theworkisthework/terraPen-mechanical-design-files/README.md

# terraPen-mechanical-design-files
3D files &amp; BOM for A2 terraPen coreXY Plotter
