theworkisthework/terraPen-mechanical-design-files/terraPenA2 BOM.xlsx

Sheet: BOM
terraPen A2 – Bill of Materials (v2.4)
Public bill of materials for one terraPen A2. Prices are kept in a separate internal workbook.
Status: | OK – matches old master | CHANGED – qty differs from old master |  | NEW – missing from old master | CHECK – needs your decision
Ref | Part | Spec / size | Qty | Used in | Supplier | Primary link | eBay UK | Amazon UK | AliExpress
1 FRAME & STRUCTURE
1.01 | 2020 T-slot extrusion | 760 mm, cut, M5 tapped both ends | 4 | Frame – width | KJN Aluminium Profile (cut to size) | Open page (https://www.aluminium-profile.co.uk/black-ir-20x20-profile-ir37015blk/) | eBay (https://www.ebay.co.uk/sch/i.html?_nkw=2020+T+slot+aluminium+extrusion+760mm+cut+to+length) | Amazon (https://www.amazon.co.uk/s?k=2020+T+slot+aluminium+extrusion+760mm+cut+to+length) | AliExpress (https://www.aliexpress.com/wholesale?SearchText=2020+T+slot+aluminium+extrusion+760mm+cut+to+length)
1.02 | 2020 T-slot extrusion | 560 mm, cut, M5 tapped both ends | 4 | Frame – length | KJN Aluminium Profile (cut to size) | Open page (https://www.aluminium-profile.co.uk/black-ir-20x20-profile-ir37015blk/) | eBay (https://www.ebay.co.uk/sch/i.html?_nkw=2020+T+slot+aluminium+extrusion+560mm+cut+to+length) | Amazon (https://www.amazon.co.uk/s?k=2020+T+slot+aluminium+extrusion+560mm+cut+to+length) | AliExpress (https://www.aliexpress.com/wholesale?SearchText=2020+T+slot+aluminium+extrusion+560mm+cut+to+length)
1.03 | 2020 T-slot extrusion | 710 mm, cut (X rail) | 1 | Frame – X rail | KJN Aluminium Profile (cut to size) | Open page (https://www.aluminium-profile.co.uk/black-ir-20x20-profile-ir37015blk/) | eBay (https://www.ebay.co.uk/sch/i.html?_nkw=2020+T+slot+aluminium+extrusion+710mm+cut+to+length) | Amazon (https://www.amazon.co.uk/s?k=2020+T+slot+aluminium+extrusion+710mm+cut+to+length) | AliExpress (https://www.aliexpress.com/wholesale?SearchText=2020+T+slot+aluminium+extrusion+710mm+cut+to+length)
1.04 | 2020 T-slot extrusion | 50 mm, cut (uprights / legs), M5 tapped both ends | 4 | Frame – height | KJN Aluminium Profile (cut to size) | Open page (https://www.aluminium-profile.co.uk/black-ir-20x20-profile-ir37015blk/) | eBay (https://www.ebay.co.uk/sch/i.html?_nkw=2020+T+slot+aluminium+extrusion+45mm+cut) | Amazon (https://www.amazon.co.uk/s?k=2020+T+slot+aluminium+extrusion+45mm+cut) | AliExpress (https://www.aliexpress.com/wholesale?SearchText=2020+T+slot+aluminium+extrusion+45mm+cut)
1.05 | 2020 corner cube connector | 3-way, 20x20x20, black, 6 mm T-slot; sold as 12 with screws | 8 | Frame – corners | AliExpress (12 pcs) | Open page (https://www.aliexpress.com/item/1005013477214655.html) | eBay (https://www.ebay.co.uk/sch/i.html?_nkw=2020+3+way+corner+cube+connector+aluminium+profile) | Amazon (https://www.amazon.co.uk/s?k=2020+3+way+corner+cube+connector+aluminium+profile) | AliExpress (https://www.aliexpress.com/wholesale?SearchText=2020+3+way+corner+cube+connector+aluminium+profile)
1.06 | 2020 corner bracket | 90 degree, 20 x 20 x 17 mm aluminium; sold as 10 (5 machines) | 2 | Frame | AliExpress (10 pcs) | Open page (https://www.aliexpress.com/item/4000190579760.html) | eBay (https://www.ebay.co.uk/sch/i.html?_nkw=2020+aluminium+profile+90+degree+corner+bracket+L) | Amazon (https://www.amazon.co.uk/s?k=2020+aluminium+profile+90+degree+corner+bracket+L) | AliExpress (https://www.aliexpress.com/wholesale?SearchText=2020+aluminium+profile+90+degree+corner+bracket+L)
1.07 | Rubber feet | 20 mm dia x 15 mm high, conical black rubber with steel washer; sold in lots of 4 (one machine) | 4 | Frame – base | AliExpress (lot of 4) | Open page (https://www.aliexpress.com/item/33014925172.html) | eBay (https://www.ebay.co.uk/sch/i.html?_nkw=rubber+feet+20mm+diameter+15mm+high+M5) | Amazon (https://www.amazon.co.uk/s?k=rubber+feet+20mm+diameter+15mm+high+M5) | AliExpress (https://www.aliexpress.com/wholesale?SearchText=rubber+feet+20mm+diameter+15mm+high+M5)
1.09 | Metal baseboard with vinyl sticker | Ferrous Dibond-style composite, cut to shape; profile 'tP_Bed_Profile_Revised.dxf', artwork 'Diabond vinyl revised .ai' (both in /metal bed) | 1 | Base | Local sign shop | DXF file (https://github.com/theworkisthework/terraPen-mechanical-design-files/blob/main/metal%20bed/tP_Bed_Profile_Revised.dxf) | – | – | –
1.10 | IR Cover reduction profile (5), black (cosmetic slot cover) | KJN37080, 2 m lengths, fits the 5 mm slot; cut list about 5.8 m (6 x 560, 2 x 760, 1 x 710, 4 x 50 mm) | 3 | Frame – top and side trim, front legs | KJN Aluminium Profile | Open page (https://www.aluminium-profile.co.uk/cover-reduction-profile-kjn37080/)
1.11 | Corner cube hole caps, plastic | 11 mm plastic caps; sold as 100 pcs | 12 | Frame corners (cubes) | eBay UK (100 pcs) | Open page (https://www.ebay.co.uk/itm/206068130690?var=506833273757)
1.12 | Rubber bungs | 11 mm rubber bungs; sold as 50 pcs | 8 | Both sides of the plotter | eBay UK (50 pcs) | Open page (https://www.ebay.co.uk/itm/404287645922?var=674191197230)
1.13 | Neodymium magnets | Strong rare-earth magnets; sold as 50 | 4 | Metal bed (4 per machine); where exactly to confirm | eBay UK (50 pcs) | Open page (https://www.ebay.co.uk/itm/326521985418)
1.14 | Neodymium magnets, black, second listing | Sold as 4 | 4 | To confirm | eBay UK (4 pcs) | Open page (https://www.ebay.co.uk/itm/318885672822?var=617097751297)
2 LINEAR MOTION
2.01 | Linear rail + 1 block, MGN9H | 540 mm (Y axis) | 2 | Y left / Y right | Jugetek (custom cut) | Open page (https://www.jugetek.com/product-page/black-anodized-linear-rail-mgn7-mgn9-mgn12-mgn15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) | eBay (https://www.ebay.co.uk/sch/i.html?_nkw=MGN9H+linear+rail+540mm+with+carriage) | Amazon (https://www.amazon.co.uk/s?k=MGN9H+linear+rail+540mm+with+carriage) | AliExpress (https://www.aliexpress.com/wholesale?SearchText=MGN9H+linear+rail+540mm+with+carriage)
2.02 | Linear rail + 1 block, MGN9H | 710 mm (X axis) | 1 | X rail / carriage | Jugetek (custom cut) | Open page (https://www.jugetek.com/product-page/black-anodized-linear-rail-mgn7-mgn9-mgn12-mgn15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) | eBay (https://www.ebay.co.uk/sch/i.html?_nkw=MGN9H+linear+rail+710mm+with+carriage) | Amazon (https://www.amazon.co.uk/s?k=MGN9H+linear+rail+710mm+with+carriage) | AliExpress (https://www.aliexpress.com/wholesale?SearchText=MGN9H+linear+rail+710mm+with+carriage)
2.03 | Linear rail + 1 block, MGN7H | 50 mm (Z / pen lift) | 1 | Tool head | Jugetek (custom cut) | Open page (https://www.jugetek.com/product-page/black-anodized-linear-rail-mgn7-mgn9-mgn12-mgn15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) | eBay (https://www.ebay.co.uk/sch/i.html?_nkw=MGN7H+50mm+linear+rail+with+carriage+block) | Amazon (https://www.amazon.co.uk/s?k=MGN7H+50mm+linear+rail+with+carriage+block) | AliExpress (https://www.aliexpress.com/wholesale?SearchText=MGN7H+50mm+linear+rail+with+carriage+block)
3 DRIVE – BELTS, PULLEYS, MOTORS
3.01 | GT2 timing belt, open | 6 mm wide, open-ended, rubber/aramid; 4.2 m per machine (qty is in metres) | 4.2 | X and Y belts | AliExpress (5 m length) | Open page (https://www.aliexpress.com/item/10000401582873.html) | eBay (https://www.ebay.co.uk/sch/i.html?_nkw=GT2+timing+belt+6mm+open+3m) | Amazon (https://www.amazon.co.uk/s?k=GT2+timing+belt+6mm+open+3m) | AliExpress (https://www.aliexpress.com/wholesale?SearchText=GT2+timing+belt+6mm+open+3m)
3.02 | GT2 pulley, toothed drive | 20T, 5 mm bore, 6 mm belt; sold as 10 | 2 | X motor, Y motor | AliExpress (10 pcs) | Open page (https://www.aliexpress.com/item/1005010499786326.html) | eBay (https://www.ebay.co.uk/sch/i.html?_nkw=GT2+20+tooth+pulley+5mm+bore+6mm+belt) | Amazon (https://www.amazon.co.uk/s?k=GT2+20+tooth+pulley+5mm+bore+6mm+belt) | AliExpress (https://www.aliexpress.com/wholesale?SearchText=GT2+20+tooth+pulley+5mm+bore+6mm+belt)
3.03 | GT2 idler, smooth | 20T smooth (no teeth), 5 mm bore, 6 mm belt, with bearing; sold as 4 | 4 | X/Y idlers, Y left/right, motor mounts | AliExpress (4 pcs) | Open page (https://www.aliexpress.com/item/32726309946.html) | eBay (https://www.ebay.co.uk/sch/i.html?_nkw=GT2+20T+smooth+idler+pulley+5mm+bore+6mm+belt) | Amazon (https://www.amazon.co.uk/s?k=GT2+20T+smooth+idler+pulley+5mm+bore+6mm+belt) | AliExpress (https://www.aliexpress.com/wholesale?SearchText=GT2+20T+smooth+idler+pulley+5mm+bore+6mm+belt)
3.04 | GT2 idler, toothed | 20T, 5 mm bore, 6 mm belt, with bearing; sold as 10 | 8 | X/Y idlers, Y left/right, motor mounts | AliExpress (10 pcs) | Open page (https://www.aliexpress.com/item/32726309946.html) | eBay (https://www.ebay.co.uk/sch/i.html?_nkw=GT2+20T+toothed+idler+pulley+5mm+bore+6mm+belt+with+bearing) | Amazon (https://www.amazon.co.uk/s?k=GT2+20T+toothed+idler+pulley+5mm+bore+6mm+belt+with+bearing) | AliExpress (https://www.aliexpress.com/wholesale)
3.05 | NEMA 17 stepper motor, 17HS15-1504S-X1 | 42x42x39 mm (page also says 40), 1.8 deg, 1.5 A, 45 N.cm, 2.3 ohm, 4.4 mH; 5 mm D-cut shaft; 1 m lead with pin connector | 2 | X motor, Y motor | StepperOnline UK | Open page (https://www.stepperonline.co.uk/nema-17-bipolar-45ncm-63-74oz-in-1-5a-42x42x39mm-4-wires-w-1m-pin-connector-17hs15-1504s-x1.html) | eBay (https://www.ebay.co.uk/sch/i.html?_nkw=NEMA+17+stepper+1.7A+42x42x38+bipolar) | Amazon (https://www.amazon.co.uk/s?k=NEMA+17+stepper+1.7A+42x42x38+bipolar) | AliExpress (https://www.aliexpress.com/wholesale?SearchText=NEMA+17+stepper+1.7A+42x42x38+bipolar)
4 ELECTRONICS
4.01 | Emerald Dingo ESP32 plotter controller (RevB) | FluidNC, 2-axis, TMC2130 driver sockets, USB-C | 1 | Electronics enclosure | terrapen.xyz | Open page (https://terrapen.xyz/products/emerald-dingo-esp32-plotter-controller?variant=64807034749305) | – | – | –
4.02 | TMC2130 stepper driver | 3: X, Y and Z (Z via the Z-axis add-on) | 3 | Controller | AliExpress | Open page (https://www.aliexpress.com/item/1005004590796152.html) | – | – | –
4.03 | Emerald Dingo Z-axis add-on | Z motor add-on; the Z lead plugs into this | 1 | Controller | terrapen.xyz | Open page (https://terrapen.xyz/products/emerald-dingo-esp32-plotter-controller?variant=64807034749305) | – | – | –
4.04 | Micro SD card, 2 GB | Cloudisk 2 GB microSD with adapter; sold as 5 | 1 | Controller | Amazon UK (5 pack) | Open page (https://www.amazon.co.uk/dp/B07R2J5CC4) | eBay (https://www.ebay.co.uk/sch/i.html?_nkw=microSD+card+8GB+SanDisk) | Amazon (https://www.amazon.co.uk/s?k=microSD+card+8GB+SanDisk) | AliExpress (https://www.aliexpress.com/wholesale?SearchText=microSD+card+8GB+SanDisk)
4.05 | Power supply, 12 V dc, 2.5 A (Ideal Power 15DYS830-120250W-K) | 12 V 2.5 A, 2.1 x 5.5 mm centre-positive barrel plug, 1.5 m lead, interchangeable AU/EU/UK/US mains plugs | 1 | Power | Farnell UK | Open page (https://uk.farnell.com/ideal-power/15dys830-120250w-k/adapter-ac-dc-12v-2-5a/dp/3703709) | eBay (https://www.ebay.co.uk/sch/i.html?_nkw=12V+2A+power+supply+5.5x2.1mm+UK+plug) | Amazon (https://www.amazon.co.uk/s?k=12V+2A+power+supply+5.5x2.1mm+UK+plug) | AliExpress (https://www.aliexpress.com/wholesale?SearchText=12V+2A+power+supply+5.5x2.1mm+UK+plug)
4.06 | Motor cable, 4-way | 4-core PVC cable, 26 AWG, flexible, unshielded, 920 mm, JST PH 2.0 | 1 | X motor |  | – | eBay (https://www.ebay.co.uk/sch/i.html?_nkw=JST+PH+2.0+4+pin+cable+750mm) | Amazon (https://www.amazon.co.uk/s?k=JST+PH+2.0+4+pin+cable+750mm) | AliExpress (https://www.aliexpress.com/wholesale?SearchText=JST+PH+2.0+4+pin+cable+750mm)
4.07 | Motor cable, 4-way | 4-core PVC cable, 26 AWG, flexible, unshielded, 515 mm, JST PH 2.0 | 1 | Y motor |  | – | eBay (https://www.ebay.co.uk/sch/i.html?_nkw=JST+PH+2.0+4+pin+cable+500mm) | Amazon (https://www.amazon.co.uk/s?k=JST+PH+2.0+4+pin+cable+500mm) | AliExpress (https://www.aliexpress.com/wholesale?SearchText=JST+PH+2.0+4+pin+cable+500mm)
4.08 | Hook-up wire, Alpha Wire 3049 BK001 | 26 AWG PVC black, 7 x 34 tinned stranded, 300 V (order code 01-5540). Sold on a 1000 ft (304.8 m) reel; only part of it is used per machine | 15 | Z motor lead (4 x 2100 mm) and X endstop lead (3 x 2100 mm) = 14.7 m, 15 m with trimming | Rapid Electronics | Open page (https://www.rapidonline.com/alpha-wire-3049-bk001-26-awg-pvc-black-hook-up-wire-1kft-01-5540) | – | – | –
4.09 | Multicore cable, 4-core PVC | 26 AWG, flexible PVC, unshielded: X lead 920 mm + Y lead 515 mm (1.435 m), plus spare | 1.5 | X and Y motors | eBay UK (20 m reel) | Open page (https://www.ebay.co.uk/itm/398302213229?var=666566085777) | eBay (https://www.ebay.co.uk/sch/i.html?_nkw=4+core+26+AWG+PVC+cable+per+metre) | Amazon (https://www.amazon.co.uk/s?k=4+core+26+AWG+PVC+cable+per+metre) | AliExpress (https://www.aliexpress.com/wholesale?SearchText=4+core+26+AWG+PVC+cable+per+metre)
4.10 | Multicore cable, 3-core PVC | 3-core PVC, 26 AWG (confirm); Y endstop lead only, 920 mm, plus spare | 1 | Y endstop | eBay UK (20 m reel) | Open page (https://www.ebay.co.uk/itm/398302213229?var=666566085742) | eBay (https://www.ebay.co.uk/sch/i.html?_nkw=3+core+26+AWG+PVC+cable+per+metre) | Amazon (https://www.amazon.co.uk/s?k=3+core+26+AWG+PVC+cable+per+metre) | AliExpress (https://www.aliexpress.com/wholesale?SearchText=3+core+26+AWG+PVC+cable+per+metre)
4.11 | JST PH 2.0 connector kit | 420 pcs: PH housings (2 to 6-way, male and female) and 270 crimp terminals; sold as one kit | 1 | All JST PH plugs: controller ends (3 x 4-way motor/Z, 2 x 3-way endstop) and motor ends (2 x 6-way) | eBay UK (kit) | Open page (https://www.ebay.co.uk/itm/307018351125) | eBay (https://www.ebay.co.uk/sch/i.html?_nkw=JST+PH+2.0+connector+housing+crimp+kit) | Amazon (https://www.amazon.co.uk/s?k=JST+PH+2.0+connector+housing+crimp+kit) | AliExpress (https://www.aliexpress.com/wholesale?SearchText=JST+PH+2.0+connector+housing+crimp+kit)
4.12 | Insulation tape for colour-coding | Red, green, yellow and blue, cut into 1 mm strips wrapped near each crimp | 4 | Z lead and other single-core wires | Local shop (similar on eBay) | – | eBay (https://www.ebay.co.uk/sch/i.html?_nkw=insulation+tape+assorted+colours+electrical+PVC) | Amazon (https://www.amazon.co.uk/s?k=insulation+tape+assorted+colours+electrical+PVC) | AliExpress (https://www.aliexpress.com/wholesale?SearchText=insulation+tape+assorted+colours+electrical+PVC)
4.13 | JST SM 2.54 mm connector kit | 200 pcs: SM-02 to SM-05 male and female housings (5 of each) + 80 bare female and 80 bare male terminals | 1 | Z motor lead (1 x 4F, 1 x 4M); X and Y endstop leads (2 x 3F) | eBay UK (kit) | Open page (https://www.ebay.co.uk/itm/820271314350) | eBay (https://www.ebay.co.uk/sch/i.html?_nkw=JST+SM+connector+kit+male+female+crimp+2.5mm) | Amazon (https://www.amazon.co.uk/s?k=JST+SM+connector+kit+male+female+crimp+2.5mm) | AliExpress (https://www.aliexpress.com/wholesale?SearchText=JST+SM+connector+kit+male+female+crimp+2.5mm)
4.14 | Optical endstop | 3-pin module (SIG / GND / VCC) | 2 | X and Y limits | Ooznest (SKU ESTOP-O) | Open page (https://ooznest.co.uk/product/optical-endstop/) | eBay (https://www.ebay.co.uk/sch/i.html?_nkw=optical+endstop+switch+module+3D+printer) | Amazon (https://www.amazon.co.uk/s?k=optical+endstop+switch+module+3D+printer) | AliExpress (https://www.aliexpress.com/wholesale?SearchText=optical+endstop+switch+module+3D+printer)
4.15 | Standoff, male-female, polyamide (WA-SPAIE) | M3 x 18 mm, hex 6 mm, black; Wurth Elektronik 971180365 | 2 | Electronics enclosure | Mouser UK | Open page (https://www.mouser.co.uk/en/ProductDetail/Wurth-Elektronik/971180365?qs=%252BEew9%252B0nqrDVrObtSz99Gg%3D%3D) | eBay (https://www.ebay.co.uk/sch/i.html?_nkw=nylon+M3+standoff+20mm) | Amazon (https://www.amazon.co.uk/s?k=nylon+M3+standoff+20mm) | AliExpress (https://www.aliexpress.com/wholesale?SearchText=nylon+M3+standoff+20mm)
4.16 | Standoff, male-female, nylon (Essentra 36M30MF016) | M3 x 16 mm hex standoff, 6 mm hex, natural nylon 6/6 (Z add-on only) | 1 | Electronics enclosure, only if you fit the Z-axis add-on | Mouser UK | Open page (https://www.mouser.co.uk/en/ProductDetail/Essentra/36M30MF016?qs=PzGy0jfpSMv9qGPovnFAAw%3D%3D)
4.17 | DC barrel jack: plug and socket pair | Plug + female socket (size to confirm); sold as 10 pairs | 1 | Power connection | eBay UK (10 pairs) | Open page (https://www.ebay.co.uk/itm/224610270674)
4.18 | Mains/power lead wire, 2-core 18 AWG | 18 AWG 2-core, 16 A rated; about 750 mm per machine, sold in 10 m lengths | 0.75 | Power wiring | eBay UK (10 m) | Open page (https://www.ebay.co.uk/itm/377319331207?var=645666841133)
4.19 | Power switch, rocker | Rocker switch; sold as 5 pcs | 1 | Power switch mount | eBay UK (5 pcs) | Open page (https://www.ebay.co.uk/itm/398214541037)
4.21 | Waveshare round display (terraDial) | Optional dial controller module for the terraDial add-on | 0 | Optional: terraDial | AliExpress | Open page (https://www.aliexpress.com/item/1005010074372646.html)
5 CABLE MANAGEMENT & MISC
5.01 | Cable chain | 7 x 7 mm inner, black nylon, sold in 1 m lengths with 2 end connectors; about 1.4 m needed (qty in metres) | 1.4 | Y right and carriage | AliExpress (1 m lengths) | Open page (https://www.aliexpress.com/item/10000358224332.html) | eBay (https://www.ebay.co.uk/sch/i.html?_nkw=7x7+cable+drag+chain+1m) | Amazon (https://www.amazon.co.uk/s?k=7x7+cable+drag+chain+1m) | AliExpress (https://www.aliexpress.com/wholesale?SearchText=7x7+cable+drag+chain+1m)
5.02 | D-Line Micro+ trunking, black | 20 x 10 mm, 2 m length, self-adhesive (Screwfix 960RA); about 1.6 m needed | 1 | Underside cable routing | Screwfix | Open page (https://www.screwfix.com/p/d-line-pvc-black-micro-trunking-20mm-x-10mm-x-2m/960ra)
5.03 | Trunking 90-degree flat corner | Print your own (D_Line_20x10_Flat_corner.stl, see 10.50), or the D-Line accessories pack (5 pieces, black) | 2 | Underside cable routing | Screwfix, or print in-house | Open page (https://www.screwfix.com/p/d-line-abs-plastic-black-trunking-accessories-5-pieces/117fg)
5.04 | Cable ties | Black nylon, 2.5 mm wide; sold as 100 | 6 | General | eBay UK (100 pcs) | Open page (https://www.ebay.co.uk/itm/366488071588?var=636217771991) | eBay (https://www.ebay.co.uk/sch/i.html?_nkw=cable+ties+100mm+x+2.5mm) | Amazon (https://www.amazon.co.uk/s?k=cable+ties+100mm+x+2.5mm) | AliExpress (https://www.aliexpress.com/wholesale?SearchText=cable+ties+100mm+x+2.5mm)
5.05 | Hex key set | 1.5 / 2 / 2.5 / 3 / 4 mm | 1 | Assembly (tool) |  | – | eBay (https://www.ebay.co.uk/sch/i.html?_nkw=hex+key+set+1.5+2+2.5+3+4mm) | Amazon (https://www.amazon.co.uk/s?k=hex+key+set+1.5+2+2.5+3+4mm) | AliExpress (https://www.aliexpress.com/wholesale?SearchText=hex+key+set+1.5+2+2.5+3+4mm)
6 FASTENERS – M2
6.02 | Socket head screw | M2 x 8, self colour, hex socket | 7 | Stepper tool head: MGN7H rail on the plate | Allfix | Open page (https://allfix.co.uk/m2-x-8-socket-head-capscrew-steel-self-colour-scp0scm020x0008.html)
6.04 | Heat-set insert | M2 x 3 mm brass | 3 | Tool head | eBay UK (100 pack) | Open page (https://www.ebay.co.uk/itm/316492832478) | eBay (https://www.ebay.co.uk/sch/i.html?_nkw=M2+heat+set+threaded+insert+brass) | Amazon (https://www.amazon.co.uk/s?k=M2+heat+set+threaded+insert+brass) | AliExpress (https://www.aliexpress.com/wholesale?SearchText=M2+heat+set+threaded+insert+brass)
7 FASTENERS – M3
7.01 | Countersunk screw | M3 x 5, self colour, hex socket | 6 | Y right, carriage, tool head | Allfix | Open page (https://allfix.co.uk/m3-x-5-socket-countersunk-steel-self-colour-sck0scm030x0005.html) | – | – | –
7.02 | Countersunk screw | M3 x 6, self colour, hex socket | 17 | Y left/right, carriage, tool head, electronics | Allfix | Open page (https://allfix.co.uk/m3-x-6-socket-countersunk-steel-self-colour-sck0scm030x0006.html) | – | – | –
7.03 | Countersunk screw | M3 x 8, self colour, hex socket | 15 | Y right | Allfix | Open page (https://allfix.co.uk/m3-x-8-socket-countersunk-steel-self-colour-sck0scm030x0008.html) | – | – | –
7.05 | Countersunk screw | M3 x 16, self colour, hex socket | 5 | To confirm | Allfix | Open page (https://allfix.co.uk/m3-x-16-socket-countersunk-steel-self-colour-sck0scm030x0016.html)
7.07 | Countersunk screw | M3 x 30, self colour, hex socket | 4 | X/Y motor mount | Allfix | Open page (https://allfix.co.uk/m3-x-30-socket-countersunk-steel-self-colour-sck0scm030x0030.html) | – | – | –
7.08 | Button head screw | M3 x 6, self colour, hex socket | 6 | Tool head, electronics | Allfix | Open page (https://allfix.co.uk/m3-x-6-socket-button-head-steel-self-colour-sbn0scm030x0006.html) | – | – | –
7.09 | Button head screw | M3 x 8, self colour, hex socket | 1 | Controller board, only with the Z-axis add-on | Allfix | Open page (https://allfix.co.uk/m3-x-8-socket-button-head-steel-self-colour-sbn0scm030x0008.html)
7.10 | Button head screw | M3 x 16 (approx.), self colour, hex socket; feet are bought without a bolt | 4 | Frame – feet | Allfix | Open page (https://allfix.co.uk/m3-x-16-socket-button-head-steel-self-colour-sbn0scm030x0016.html) | – | – | –
7.12 | Socket head screw | M3 x 8, self colour, hex socket | 14 | Frame – rails | Allfix | Open page (https://allfix.co.uk/m3-x-8-socket-head-capscrew-steel-self-colour-scp0scm030x0008.html) | – | – | –
7.13 | Nyloc nut | M3, A2-304 stainless steel, DIN 985 type T | 2 | Z tool head (new) | Allfix | Open page (https://allfix.co.uk/m3-nyloc-nut-type-t-a2-304-stainless-steel-din-985-nunt2scm030.html)
7.14 | T-slot nut with spring ball, M3 (IR Slot 5 slide block) | KJN43719, M3, 5 mm slot, 8 x 4.2 mm, zinc-plated steel, stainless spring ball | 17 | Frame – rails and feet | KJN Aluminium Profile | Open page (https://www.aluminium-profile.co.uk/t-slot-nut-5-st-m3-with-spring-ball-kjn43719/) | eBay (https://www.ebay.co.uk/sch/i.html?_nkw=M3+drop+in+T+nut+2020+profile) | Amazon (https://www.amazon.co.uk/s?k=M3+drop+in+T+nut+2020+profile) | AliExpress (https://www.aliexpress.com/wholesale?SearchText=M3+drop+in+T+nut+2020+profile)
7.15 | Heat-set insert | M3 x 3 mm brass | 1 | Belt clamp, rear of the tool head | The Pi Hut | Open page (https://thepihut.com/products/brass-heat-set-inserts-for-plastic-m3-x-3mm-50-pack) | eBay (https://www.ebay.co.uk/sch/i.html?_nkw=M3+heat+set+insert+M3x3+brass) | Amazon (https://www.amazon.co.uk/s?k=M3+heat+set+insert+M3x3+brass) | AliExpress (https://www.aliexpress.com/wholesale?SearchText=M3+heat+set+insert+M3x3+brass)
8 FASTENERS – M5
8.01 | Countersunk screw | M5 x 8, self colour, hex socket | 33 | Motors, idlers, Y left/right (18); metal bed (8) | Allfix | Open page (https://allfix.co.uk/m5-x-8-socket-countersunk-steel-self-colour-sck0scm050x0008.html) | – | – | –
8.02 | Countersunk screw | M5 x 20, self colour, hex socket | 6 | Y left/right – X rail mounting | Allfix | Open page (https://allfix.co.uk/m5-x-20-socket-countersunk-steel-self-colour-sck0scm050x0020.html) | – | – | –
8.04 | Button head screw | M5 x 12, self colour, hex socket | 22 | Frame – corner cubes (all 22) | Allfix | Open page (https://allfix.co.uk/m5-x-12-socket-button-head-steel-self-colour-sbn0scm050x0012.html)
8.05 | Button head screw | M5 x 8, self colour, hex socket | 6 | Frame 90-degree corners (4), electronics enclosure (2) | Allfix | Open page (https://allfix.co.uk/m5-x-8-socket-button-head-steel-self-colour-sbn0scm050x0008.html) | – | – | –
8.07 | T-slot nut with spring ball, M5 (IR Slot 5 slide block) | KJN37001, M5, 5 mm slot, 8 x 4.2 mm, zinc-plated steel, stainless spring ball | 43 | Motors, idlers, Y left/right, frame rails | KJN Aluminium Profile | Open page (https://www.aluminium-profile.co.uk/t-slot-nut-5-st-m3-with-spring-ball-pk-10-kjn37001/) | eBay (https://www.ebay.co.uk/sch/i.html?_nkw=M5+drop+in+T+nut+2020+profile) | Amazon (https://www.amazon.co.uk/s?k=M5+drop+in+T+nut+2020+profile) | AliExpress (https://www.aliexpress.com/wholesale?SearchText=M5+drop+in+T+nut+2020+profile)
8.08 | Allfix fixings – total for one machine | All the Allfix screws and nuts above, at exact per-machine quantities | 1 | Whole machine | Allfix | –
9 Z-STEPPER PEN-LIFT HEAD
9.01 | NEMA 14 stepper motor, 14HS17-0504S | 35 x 35 x 42 mm, 1.8 deg, 0.5 A, 23 N·cm; 5 mm D-cut shaft (24 mm); 300 mm lead, 4 wires | 1 | Pen lift | StepperOnline UK | Open page (https://www.stepperonline.co.uk/nema-14-bipolar-1-8deg-23ncm-32-57oz-in-0-5a-35x35x42mm-4-wires-14hs17-0504s.html) | eBay (https://www.ebay.co.uk/sch/i.html?_nkw=NEMA+14+stepper+motor+35mm+bipolar+1.8+degree) | Amazon (https://www.amazon.co.uk/s?k=NEMA+14+stepper+motor+35mm+bipolar+1.8+degree) | AliExpress (https://www.aliexpress.com/wholesale?SearchText=NEMA+14+stepper+motor+35mm+bipolar+1.8+degree)
9.02 | GT2 timing belt, 6 mm (pen lift) | 6 mm wide, about 40 mm, cut from the same reel as the X/Y belts (row 3.01); qty in metres | 0.04 | Pen lift | AliExpress (same reel as 3.01) | Open page (https://www.aliexpress.com/item/10000401582873.html) | eBay (https://www.ebay.co.uk/sch/i.html?_nkw=GT2+timing+belt+6mm+open+per+metre) | Amazon (https://www.amazon.co.uk/s?k=GT2+timing+belt+6mm+open+per+metre) | AliExpress (https://www.aliexpress.com/wholesale?SearchText=GT2+timing+belt+6mm+open+per+metre)
9.03 | Z motor lead (through the energy chain) | 4 x single-core Alpha Wire 3049 BK001, 26 AWG tinned copper PVC, black; 2100 mm each | 1 | Z motor | Made from the hook-up wire above | – | – | – | –
9.04 | Extension spring | 5.2 mm diameter x 20.6 mm long, 0.3 mm wire; sold as 10 | 1 | Stepper tool head (front of the plate, bottom left corner) | eBay UK (10 pcs) | Open page (https://www.ebay.co.uk/itm/406338225404?var=676666549225)
9.06 | Thumb screw, M3 x 12 | Steel thumb screw (knurled head); sold as 10 | 1 | Pen setter gauge | AliExpress (10 pcs) | Open page (https://www.aliexpress.com/item/1005009244888323.html)
10 PRINTED PARTS (STL – print in-house)
10.01 | X idler top (XIT) | X_Idler_Top.stl | 1 | X idler | Print in-house | Link (https://github.com/theworkisthework/terraPen-mechanical-design-files/blob/main/STLs/X_Idler_Top.stl) | – | – | –
10.02 | X idler bottom (XIB) | X_Idler_Bottom.stl | 1 | X idler | Print in-house | Link (https://github.com/theworkisthework/terraPen-mechanical-design-files/blob/main/STLs/X_Idler_Bottom.stl) | – | – | –
10.03 | Y idler top (YIT) | Y_Idler_Top.stl | 1 | Y idler | Print in-house | Link (https://github.com/theworkisthework/terraPen-mechanical-design-files/blob/main/STLs/Y_Idler_Top.stl) | – | – | –
10.04 | Y idler bottom (YIB) | Y_Idler_Bottom.stl | 1 | Y idler | Print in-house | Link (https://github.com/theworkisthework/terraPen-mechanical-design-files/blob/main/STLs/Y_Idler_Bottom.stl) | – | – | –
10.05 | X motor top (XMT) | X_Motor_Top.stl | 1 | X motor | Print in-house | Link (https://github.com/theworkisthework/terraPen-mechanical-design-files/blob/main/STLs/X_Motor_Top.stl) | – | – | –
10.06 | X motor bottom (XMB) | X_Motor_Bottom.stl | 1 | X motor | Print in-house | Link (https://github.com/theworkisthework/terraPen-mechanical-design-files/blob/main/STLs/X_Motor_Bottom.stl) | – | – | –
10.07 | Y motor top (YMT) | Y_Motor_Top.stl | 1 | Y motor | Print in-house | Link (https://github.com/theworkisthework/terraPen-mechanical-design-files/blob/main/STLs/Y_Motor_Top.stl) | – | – | –
10.08 | Y motor bottom (YMB) | Y_Motor_Bottom.stl | 1 | Y motor | Print in-house | Link (https://github.com/theworkisthework/terraPen-mechanical-design-files/blob/main/STLs/Y_Motor_Bottom.stl) | – | – | –
10.09 | X axis bracket top, left (XYT) | Xy_Carriage_Top.stl | 1 | Y left | Print in-house | Link (https://github.com/theworkisthework/terraPen-mechanical-design-files/blob/main/STLs/Xy_Carriage_Top.stl) | – | – | –
10.10 | X axis bracket bottom, left (XYB) | Xy_Carriage_Bottom.stl | 1 | Y left | Print in-house | Link (https://github.com/theworkisthework/terraPen-mechanical-design-files/blob/main/STLs/Xy_Carriage_Bottom.stl) | – | – | –
10.11 | X axis bracket top, right (YXT) | Xx_Carriage_Top.stl | 1 | Y right | Print in-house | Link (https://github.com/theworkisthework/terraPen-mechanical-design-files/blob/main/STLs/Xx_Carriage_Top.stl) | – | – | –
10.12 | X axis bracket bottom, right (YXB) | Xx_Carraiage_Bottom.stl | 1 | Y right | Print in-house | Link (https://github.com/theworkisthework/terraPen-mechanical-design-files/blob/main/STLs/Xx_Carraiage_Bottom.stl) | – | – | –
10.14 | Carriage (RUM) | Tool_Carriage.stl | 1 | Carriage | Print in-house | Link (https://github.com/theworkisthework/terraPen-mechanical-design-files/blob/main/STLs/Tool_Carriage.stl) | – | – | –
10.15 | Belt clamp front (BCF) | Belt_Clamp_Plate.stl | 1 | Carriage | Print in-house | Link (https://github.com/theworkisthework/terraPen-mechanical-design-files/blob/main/STLs/Belt_Clamp_Plate.stl) | – | – | –
10.16 | Belt clamp back (BCB) | Belt_Clamp_Teeth.stl | 1 | Carriage | Print in-house | Link (https://github.com/theworkisthework/terraPen-mechanical-design-files/blob/main/STLs/Belt_Clamp_Teeth.stl) | – | – | –
10.17 | Tensioner housing (T) | Tensioner_Housing.stl | 1 | Carriage | Print in-house | Link (https://github.com/theworkisthework/terraPen-mechanical-design-files/blob/main/STLs/Tensioner_Housing.stl) | – | – | –
10.18 | Tensioner bit | 2xTensioner_bit.stl | 2 | Carriage | Print in-house | Link (https://github.com/theworkisthework/terraPen-mechanical-design-files/blob/main/STLs/2xTensioner_bit.stl) | – | – | –
10.20 | Minimal pen holder (MPH) | Pen_Holder_Front.stl | 1 | Tool head | Print in-house | Link (https://github.com/theworkisthework/terraPen-mechanical-design-files/blob/main/STLs/Pen_Holder_Front.stl) | – | – | –
10.21 | Pen clip block | Pen_Clip_Block.stl | 1 | Tool head | Print in-house | Link (https://github.com/theworkisthework/terraPen-mechanical-design-files/blob/main/STLs/Pen_Clip_Block.stl) | – | – | –
10.22 | Pen clip latch | Pen_Clip_Latch.stl | 1 | Tool head | Print in-house | Link (https://github.com/theworkisthework/terraPen-mechanical-design-files/blob/main/STLs/Pen_Clip_Latch.stl) | – | – | –
10.23 | Pen clip link | Pen_Clip_Link.stl | 1 | Tool head | Print in-house | Link (https://github.com/theworkisthework/terraPen-mechanical-design-files/blob/main/STLs/Pen_Clip_Link.stl) | – | – | –
10.24 | Electronics enclosure (EE) | Electronics Enclosure.stl | 1 | Electronics | Print in-house | Link (https://github.com/theworkisthework/terraPen-mechanical-design-files/blob/main/STLs/Electronics%20Enclosure.stl) | – | – | –
10.25 | Electronics enclosure top plate (EETP) | No STL found | 1 | Electronics | Print in-house | – | – | – | –
10.26 | Power enclosure box | Power_Enclosure_Box.stl | 1 | Power | Print in-house | Link (https://github.com/theworkisthework/terraPen-mechanical-design-files/blob/main/STLs/Power_Enclosure_Box.stl) | – | – | –
10.27 | Power enclosure back | Power_Enclosure_Back.stl | 1 | Power | Print in-house | Link (https://github.com/theworkisthework/terraPen-mechanical-design-files/blob/main/STLs/Power_Enclosure_Back.stl) | – | – | –
10.28 | X endstop top | Xx_Endstop_Top .stl | 1 | X endstop | Print in-house | Link (https://github.com/theworkisthework/terraPen-mechanical-design-files/blob/main/STLs/Xx_Endstop_Top%20.stl) | – | – | –
10.29 | X endstop bottom | Xx_Endstop_Bottom.stl | 1 | X endstop | Print in-house | Link (https://github.com/theworkisthework/terraPen-mechanical-design-files/blob/main/STLs/Xx_Endstop_Bottom.stl) | – | – | –
10.30 | Y endstop mount | Y_Endstop_Mount.stl | 1 | Y endstop | Print in-house | Link (https://github.com/theworkisthework/terraPen-mechanical-design-files/blob/main/STLs/Y_Endstop_Mount.stl) | – | – | –
10.31 | TPU bumper | 8xTPU_Bumper.stl | 8 | Frame / base | Print in-house | Link (https://github.com/theworkisthework/terraPen-mechanical-design-files/blob/main/STLs/8xTPU_Bumper.stl) | – | – | –
10.32 | Cable cap for extrusion | Cable Cap for Extrusion.stl | 1 | Frame | Print in-house | Link (https://github.com/theworkisthework/terraPen-mechanical-design-files/blob/main/STLs/Cable%20Cap%20for%20Extrusion.stl) | – | – | –
10.33 | Clip mount | skinnyClipMount.stl | 1 | Unknown | Print in-house | Link (https://github.com/theworkisthework/terraPen-mechanical-design-files/blob/main/STLs/skinnyClipMount.stl) | – | – | –
10.34 | Stepper tool carriage | stepper_tool_carriage.stl | 1 | Tool head (stepper) | Print in-house | Link (https://github.com/theworkisthework/terraPen-mechanical-design-files/blob/main/STLs/stepper_tool_carriage.stl) | – | – | –
10.35 | Stepper pen mount | stepper_pen_mount.stl | 1 | Tool head (stepper) | Print in-house | Link (https://github.com/theworkisthework/terraPen-mechanical-design-files/blob/main/STLs/stepper_pen_mount.stl) | – | – | –
10.36 | Stepper pen mount clamp | stepper_pen_mount_clamp.stl | 1 | Tool head (stepper) | Print in-house | Link (https://github.com/theworkisthework/terraPen-mechanical-design-files/blob/main/STLs/stepper_pen_mount_clamp.stl) | – | – | –
10.37 | Stepper belt pulley | stepper belt pulley.stl | 1 | Tool head (stepper) | Print in-house | Link (https://github.com/theworkisthework/terraPen-mechanical-design-files/blob/main/STLs/stepper%20belt%20pulley.stl) | – | – | –
10.38 | NEMA 14 mount to carriage | Nema14mount2carriage.stl | 1 | Tool head (stepper) | Print in-house | Link (https://github.com/theworkisthework/terraPen-mechanical-design-files/blob/main/STLs/Nema14mount2carriage.stl) | – | – | –
10.39 | TPU pen bung – 10mm Tapered | TPU Bungs/10mm Tapered Bung.stl | 1 | Pen holder insert | Print in-house | Link (https://github.com/theworkisthework/terraPen-mechanical-design-files/blob/main/STLs/TPU%20Bungs/10mm%20Tapered%20Bung.stl) | – | – | –
10.40 | TPU pen bung – 11mm Tapered | TPU Bungs/11mm Tapered Bung.stl | 1 | Pen holder insert | Print in-house | Link (https://github.com/theworkisthework/terraPen-mechanical-design-files/blob/main/STLs/TPU%20Bungs/11mm%20Tapered%20Bung.stl) | – | – | –
10.41 | TPU pen bung – 12mm Aperture | TPU Bungs/12mm Aperture Bung.stl | 1 | Pen holder insert | Print in-house | Link (https://github.com/theworkisthework/terraPen-mechanical-design-files/blob/main/STLs/TPU%20Bungs/12mm%20Aperture%20Bung.stl) | – | – | –
10.42 | TPU pen bung – 15mm Aperture | TPU Bungs/15mm Aperture Bung.stl | 1 | Pen holder insert | Print in-house | Link (https://github.com/theworkisthework/terraPen-mechanical-design-files/blob/main/STLs/TPU%20Bungs/15mm%20Aperture%20Bung.stl) | – | – | –
10.43 | TPU pen bung – 16_3mm Tapered | TPU Bungs/16_3mm Tapered Bung.stl | 1 | Pen holder insert | Print in-house | Link (https://github.com/theworkisthework/terraPen-mechanical-design-files/blob/main/STLs/TPU%20Bungs/16_3mm%20Tapered%20Bung.stl) | – | – | –
10.44 | TPU pen bung – 4mm Aperture | TPU Bungs/4mm Aperture Bung.stl | 1 | Pen holder insert | Print in-house | Link (https://github.com/theworkisthework/terraPen-mechanical-design-files/blob/main/STLs/TPU%20Bungs/4mm%20Aperture%20Bung.stl) | – | – | –
10.45 | TPU pen bung – 6mm Aperture | TPU Bungs/6mm Aperture Bung.stl | 1 | Pen holder insert | Print in-house | Link (https://github.com/theworkisthework/terraPen-mechanical-design-files/blob/main/STLs/TPU%20Bungs/6mm%20Aperture%20Bung.stl) | – | – | –
10.46 | TPU pen bung – 8mm Tapered | TPU Bungs/8mm Tapered Bung.stl | 1 | Pen holder insert | Print in-house | Link (https://github.com/theworkisthework/terraPen-mechanical-design-files/blob/main/STLs/TPU%20Bungs/8mm%20Tapered%20Bung.stl) | – | – | –
10.47 | TPU pen bung – 9mm Aperture | TPU Bungs/9mm Aperture Bung.stl | 1 | Pen holder insert | Print in-house | Link (https://github.com/theworkisthework/terraPen-mechanical-design-files/blob/main/STLs/TPU%20Bungs/9mm%20Aperture%20Bung.stl) | – | – | –
10.48 | TPU pen bung – 9mm Tapered | TPU Bungs/9mm Tapered Bung.stl | 1 | Pen holder insert | Print in-house | Link (https://github.com/theworkisthework/terraPen-mechanical-design-files/blob/main/STLs/TPU%20Bungs/9mm%20Tapered%20Bung.stl) | – | – | –
10.49 | TPU pen holder insert (parametric) | Stepper_Z_Axis_Experimental/Pen Holder Insert.FCStd | 1 | Pen holder insert | Print in-house | Link (https://github.com/theworkisthework/terraPen-mechanical-design-files/blob/main/Stepper_Z_Axis_Experimental/Pen%20Holder%20Insert.FCStd) | – | – | –
10.50 | D-Line 20 x 10 flat corner (trunking) | D_Line_20x10_Flat_corner.stl | 2 | Underside cable trunking | Print in-house | Link (https://github.com/theworkisthework/terraPen-mechanical-design-files/blob/main/STLs/D_Line_20x10_Flat_corner.stl)
10.51 | Chain support (energy chain anti-sag clip) | CHAIN_SUPPORT.stl | 4 | Gantry underside (energy chain); also terapixel light clips (work in progress) | Print in-house | Link (https://github.com/theworkisthework/terraPen-mechanical-design-files/blob/main/STLs/CHAIN_SUPPORT.stl)
10.52 | Printed parts – total cost for one machine | All the printed parts above, as one figure (filament and printing) | 1 | Whole machine | Print in-house | –
11 TOOLING (one-off purchases, not in the per-machine total)
11.01 | Heat-set insert tip for a soldering iron | Virtjoule, #4-40 / M3 inserts, Hakko-type tip (Pi Hut ADA4239) | 1 | Printed parts: fitting the M3 heat-set inserts | The Pi Hut | Open page (https://thepihut.com/products/heat-set-insert-for-soldering-irons-4-40-m3-inserts)
11.02 | Soldering iron that takes Hakko-type tips | To fit the insert tip above; also useful for the JST work | 1 | Fitting inserts, wiring | Any supplier | –
11.03 | M3 and M5 taps | The M5 tap is only needed if your extrusion supplier does not tap the ends. M3 is needed for printed parts | 1 | Frame extrusion ends | RS | Open page (https://uk.rs-online.com/web/p/threading-taps/2666568)
11.04 | Crimping tool for JST PH and JST SM connectors | IWISS SN-2549 ratcheting crimper, 0.08-1.0 mm², for JST PH / SM and Dupont-type terminals | 1 | Cable leads | Amazon UK | Open page (https://www.amazon.co.uk/IWISS-Crimping-0-08-1-0-Ratcheting-Connector/dp/B01N4L8QMW?th=1)

Sheet: Fixings by part
Fixings by part – walk-through of the build, bottom frame upwards (work in progress)
Dictated by Ed on 24 Oct 2026. Totals are reconciled against the BOM sheet afterwards.
Assembly / part | Fastener | Qty | Nut / insert | Qty | Supplied with part? | BOM row | Notes | Screw key | Nut key
Bottom frame – rubber feet | Button head screw, approx. M3 x 16 (length to confirm) | 4 | M3 spring-ball T-slot nut (KJN43719) | 4 | Yes, screws came with the feet | 1.07, 7.10, 7.14 | Per Ed. The BOM currently lists 4 x M3 x 12 button head for 'Frame – feet' (7.10): check whether that should be dropped or changed to 16 mm. The 4 nuts are part of the 16 M3 nuts. | M3 x 16 button head (approx.) | M3 T-nut
Bottom frame – 4 extrusions + 4 corner cubes (square) | Socket head (cap) screw M5 x 12 | 8 | None (bolts go into the tapped extrusion ends) |  | No | 1.01, 1.02, 1.05, 8.03 | Per Ed: M5 x 12 is enough (16 was considered). 2 bolts per cube x 4 cubes = 8. The third hole of each cube is still to be covered (uprights?). BOM row 8.03 has 22 in total for the whole frame. | M5 x 12 cap head
Bottom frame – bed support extrusion (horizontal cross-member, keeps the frame square), 2 x L brackets | Button head screw M5 x 8 | 4 | M5 spring-ball T-slot nut (KJN37001) | 4 | No | 1.06, 8.05, 8.07 | Per Ed. 2 screws + 2 nuts per bracket. Matches the 4 M5 x 8 button head 'frame 90-degree corners' in the BOM (8.04). The cross-member is one of the four 760 mm extrusions (confirmed by Ed). Wire slot: cut about 30 mm wide and about 7 mm deep into the extrusion so wires can be fed through; if you have no saw, drill holes through the centre instead. A plastic clip (a printed part from the mechanical design files, 'Cable Cap for Extrusion', row 10.32: confirmed by Ed) is fitted about 40 mm from one end. PHOTO NEEDED of the slot and the clip, for the docs. | M5 x 8 button head | M5 T-nut
Bottom frame – centre (760 mm) extrusion: electronics mount | Button head screw M5 x 8 | 2 | M5 spring-ball T-slot nut (KJN37001) | 2 | No | 8.05, 8.07 | Per Ed. Together with the 4 for the L brackets this makes 6, which matches the BOM's 6 x M5 x 8 button head (4 corners + 2 electronics enclosure). | M5 x 8 button head | M5 T-nut
Electronics enclosure – standoffs | Nylon standoff, M3, male-female, about 18 mm | 2 | – |  | No (Ed to check whether he has any) | 4.15 | Per Ed: the threaded end goes through the controller board and into the housing; the cover screw goes into the other end. BOM and CAD had 20 mm: confirm the length. Ed to check whether he has any. | M3 standoff, male-female (about 18 mm)
Electronics enclosure – cover | Countersunk screw M3 x 6, into the standoffs | 2 | – |  | No | 7.02 | Per Ed. | M3 x 6 countersunk
Electronics enclosure – cover (third hole) | Countersunk screw M3 x 6, into a heat-set insert in the housing | 1 | – |  | No | 7.02 or 7.03, 7.15 | Per Ed: M3 x 6 is fine (not 8). The cover has 3 holes: 2 into the standoffs and 1 into the electronics housing. The housing holes use heat-set inserts. | M3 x 6 countersunk
Emerald Dingo controller board | Button head screw M3 x 6 | 2 | – |  | No | 7.08 | Per Ed: the board has 4 mounting holes. 2 are held by the standoffs (threaded through the board into the housing); the other 2 take these M3 x 6 button head screws into heat-set inserts in the housing. The housing holes in the plastic all use heat-set inserts (count to add to the M3 inserts: 3 for the screws, probably 2 more for the standoff studs). | M3 x 6 button head
Frame – four 50 mm legs on the bottom corner cubes | Socket head (cap) screw M5 x 12 | 4 | None (bolts go into the tapped leg ends) |  | No | 1.04, 1.05, 8.03 | Per Ed (length 12 'I think', same as the other cube bolts). 1 per leg, through the cube's third hole. Running tally of cube bolts: bottom square 8 + legs 4 = 12; the other 10 of the BOM's 22 would be the top (4 at the legs, 6 for the top rails, as the front top has no rail). To confirm when we reach the top frame. | M5 x 12 cap head
Metal baseboard (new bed) – on top faces of the extrusions | Countersunk screw M5 x 8 | 8 | M5 spring-ball T-slot nut (KJN37001) | 8 | No | 1.09, 8.01, 8.07 | Per Ed: 8 mounting points = 3 on the front rail, 3 on the back rail, 2 on the left-hand side rail (top faces of the extrusions). Countersink the bed holes before the vinyl is applied. Check whether the BOM's 18 x M5 x 8 countersunk (8.01: motors, idlers, Y left/right) already includes these 8, or whether the metal bed adds 8 more. | M5 x 8 countersunk | M5 T-nut
Y endstop mount (Y_Endstop_Mount.stl) on the front-left 50 mm leg (facing the back) | Countersunk screw M5 x 8 | 1 | M5 spring-ball T-slot nut (KJN37001) | 1 | No | 8.01, 8.07 | Per Ed (confirmed): this is the Y endstop. The nut slides into the leg, facing the back, and the mount is fixed to it with one M5 x 8 countersunk screw. | M5 x 8 countersunk | M5 T-nut
Y optical endstop on its mount (Y_Endstop_Mount.stl) | Button head screw M3 x 6 | 2 | – |  | No | 7.08 | Per Ed: 6 mm (6 or 8 would do). The 2 M3 screws go into the endstop mount and screw directly into threaded plastic (confirmed), so no inserts. | M3 x 6 button head
Power switch mount on the rear-right 50 mm leg (plastic parts to be added later) | Countersunk screw M5 x 8 | 2 | M5 spring-ball T-slot nut (KJN37001) | 2 | No | 8.01, 8.07 | Per Ed (confirmed countersunk): one bolt + nut on the inside face of the leg facing the front of the machine, and one on the inside face facing the inside of the machine (the X direction). 2 bolts, 2 nuts. | M5 x 8 countersunk | M5 T-nut
Energy chain mount on the right-hand 560 mm extrusion, upright (top) face, towards the back near the leg | Countersunk screw M3 x 8 | 1 | M3 spring-ball T-slot nut (KJN43719) | 1 | No | 7.03, 7.14 | Per Ed. The BOM has 2 x M3 x 8 countersunk for 'Y right': check whether the second belongs to the same bracket (the energy chain bracket, ECB, has no STL yet). Ed on 24 Oct: the M3 x 8 connects the energy chain to an M3 sliding nut on the extrusion along the base, Y side, bottom back near the power. Confirmed by Ed: the same single screw, not a second one. | M3 x 8 countersunk | M3 T-nut
X motor assembly (NEMA 17, toothed pulley, one toothed and one smooth idler), mounted on top of the leg section | Countersunk screw M3 x 16 | 2 | – |  | No | 7.05 | Per Ed (corrected from 8 to 16). This is the use of the M3 x 16 countersunk row added from your Allfix link. | M3 x 16 countersunk
X motor assembly (NEMA 17, toothed pulley, one toothed and one smooth idler), mounted on top of the leg section | Countersunk screw M3 x 30 | 2 | – |  | No | 7.07 | Per Ed (confirmed): the motor mount's M3 x 30 screws go through the plastic straight into the threaded holes in the motor. No nuts or inserts. | M3 x 30 countersunk
X motor assembly (NEMA 17, toothed pulley, one toothed and one smooth idler), mounted on top of the leg section | Countersunk screw M5 x 8 | 3 | M5 spring-ball T-slot nut (KJN37001) | 3 | No | 8.01, 8.07 | Per Ed. | M5 x 8 countersunk | M5 T-nut
X motor assembly (NEMA 17, toothed pulley, one toothed and one smooth idler), mounted on top of the leg section – corner cube | Button head screw M5 x 12 | 2 | – |  | No | 8.04 (new M5 x 12 button head row), 8.04 | Per Ed: 2 x M5 x 12 button head hold the corner cube. This is the use of the M5 x 12 button head row added from your Allfix link. The pulley's grub screws come with the pulley. Grub screws (about M3 x 4) come with the pulleys: confirmed by Ed. | M5 x 12 button head
Y motor assembly (same layout as the X motor) | Countersunk screw M3 x 30 | 2 | – |  | No | 7.07 | Per Ed (confirmed): screws go through the plastic into the threaded holes in the motor. No nuts or inserts. | M3 x 30 countersunk
Y motor assembly (same layout as the X motor) | Countersunk screw M3 x 8 | 2 | – |  | No | 7.03 | Per Ed. | M3 x 8 countersunk
Y motor assembly (same layout as the X motor) | Countersunk screw M5 x 8 | 3 | M5 spring-ball T-slot nut (KJN37001) | 3 | No | 8.01, 8.07 | Confirmed by Ed: the Y motor matches the X motor (3 x M5 x 8 with 3 nuts). | M5 x 8 countersunk | M5 T-nut
Y motor assembly (same layout as the X motor) – corner cube | Button head screw M5 x 12 | 2 | – |  | No | 8.04 | Confirmed by Ed: as the X motor. | M5 x 12 button head
X idler assembly (back corner; mirrored, same screws as the other side; corner cube + toothed idlers) – corner cube | Button head screw M5 x 12 | 3 | – |  | No | 8.04 | Confirmed by Ed, per side: the 3 M5 x 12 button head screws hold the corner cube and mount the plastic brackets to the extrusions. | M5 x 12 button head
X idler assembly (back corner; mirrored, same screws as the other side; corner cube + toothed idlers) | Countersunk screw M5 x 8 | 4 | M5 spring-ball T-slot nut (KJN37001) | 4 | No | 8.01, 8.07 | Confirmed by Ed, per side: 4 screws with 4 nuts. | M5 x 8 countersunk | M5 T-nut
X idler assembly (back corner; mirrored, same screws as the other side; corner cube + toothed idlers) – idler clamp, bolted from the underside | Countersunk screw M5 x 20 | 1 | – (threaded plastic) |  | No | 8.02 | Confirmed by Ed, per side: the 3 M5 x 12 button head screws hold the corner cube and mount the plastic brackets to the extrusions. Confirmed by Ed: 1 per side (not 2). Of the two idlers, one has its axle printed in place and the other uses this bolt as its axle. Total with the gantry's 4 = 6 M5 x 20 (Ed). Confirmed by Ed: it screws into a threaded plastic piece, so no nut. | M5 x 20 countersunk
Y idler assembly (back corner; mirrored, same screws as the other side; corner cube + toothed idlers) – corner cube | Button head screw M5 x 12 | 3 | – |  | No | 8.04 | Confirmed by Ed, per side: the 3 M5 x 12 button head screws hold the corner cube and mount the plastic brackets to the extrusions. | M5 x 12 button head
Y idler assembly (back corner; mirrored, same screws as the other side; corner cube + toothed idlers) | Countersunk screw M5 x 8 | 4 | M5 spring-ball T-slot nut (KJN37001) | 4 | No | 8.01, 8.07 | Confirmed by Ed, per side: 4 screws with 4 nuts. | M5 x 8 countersunk | M5 T-nut
Y idler assembly (back corner; mirrored, same screws as the other side; corner cube + toothed idlers) – idler clamp, bolted from the top side | Countersunk screw M5 x 20 | 1 | – (threaded plastic) |  | No | 8.02 | Confirmed by Ed, per side: the 3 M5 x 12 button head screws hold the corner cube and mount the plastic brackets to the extrusions. Confirmed by Ed: 1 per side (not 2). Of the two idlers, one has its axle printed in place and the other uses this bolt as its axle. Total with the gantry's 4 = 6 M5 x 20 (Ed). Confirmed by Ed: it screws into a threaded plastic piece, so no nut. | M5 x 20 countersunk
Y linear rail MGN9H (black) under the left-hand top extrusion | Socket head (cap) screw M3 x 8 | 4 | M3 spring-ball T-slot nut (KJN43719) | 4 | No | 7.12, 7.14 | Per Ed: only about 4 fixings per rail are needed, although the rail has more holes. 4 per side, 8 in total. | M3 x 8 socket head | M3 T-nut
Y linear rail MGN9H (black) under the right-hand top extrusion | Socket head (cap) screw M3 x 8 | 4 | M3 spring-ball T-slot nut (KJN43719) | 4 | No | 7.12, 7.14 | Per Ed: only about 4 fixings per rail are needed, although the rail has more holes. 4 per side, 8 in total. | M3 x 8 socket head | M3 T-nut
Gantry end, X side (Y homing arm side): MGN9H block, plate, idler block | Countersunk screw M3 x 6 | 2 | – |  | No | 7.02 | Per Ed: into the MGN9H block, fixing the plate. | M3 x 6 countersunk
Gantry end, X side (Y homing arm side): MGN9H block, plate, idler block – Y homing (endstop) arm bracket | Countersunk screw M3 x 8 | 2 | – |  | No | 7.03 | Confirmed by Ed: 2 on the X side (the Y homing arm); none on the Y side. | M3 x 8 countersunk
Gantry end, X side (Y homing arm side): MGN9H block, plate, idler block – idler block to the 710 mm X rail | Countersunk screw M5 x 20 | 2 | M5 spring-ball T-slot nut (KJN37001) | 2 | No | 8.02, 8.07 | Confirmed by Ed: 2 per side, separate from the idler axle/clamp bolt (1 per side). M5 x 20 total: 2 idler + 4 gantry = 6. | M5 x 20 countersunk | M5 T-nut
Gantry end, X side (Y homing arm side): MGN9H block, plate, idler block – top plate | Countersunk screw M5 x 8 | 2 | M5 spring-ball T-slot nut (KJN37001) | 2 | No | 8.01, 8.07 | Confirmed by Ed: countersunk. 2 per side into M5 sliding nuts on the top plate. | M5 x 8 countersunk | M5 T-nut
Gantry end, X side (Y homing arm side): MGN9H block, plate, idler block – clamp top to bottom | Countersunk screw M3 x 8 | 1 | – |  | No | 7.03 | Confirmed by Ed: 1 per side. With the homing arm's 2, the X side has 3 of these screws and the Y side has 1. Idlers: a smooth one at the front and a toothed one (rounded D-shape) facing the back. | M3 x 8 countersunk
Gantry end, Y side (no homing arm): MGN9H block, plate, idler block | Countersunk screw M3 x 6 | 4 | – |  | No | 7.02 | Per Ed: the Y side has 4 M3 x 6 countersunk on the block (no homing bracket). | M3 x 6 countersunk
Gantry end, Y side (no homing arm): MGN9H block, plate, idler block – idler block to the X rail | Countersunk screw M5 x 20 | 2 | M5 spring-ball T-slot nut (KJN37001) | 2 | No | 8.02, 8.07 | Confirmed by Ed: 2 per side, separate from the idler axle/clamp bolt (1 per side). M5 x 20 total: 2 idler + 4 gantry = 6. | M5 x 20 countersunk | M5 T-nut
Gantry end, Y side (no homing arm): MGN9H block, plate, idler block – top plate | Countersunk screw M5 x 8 | 2 | M5 spring-ball T-slot nut (KJN37001) | 2 | No | 8.01, 8.07 | Confirmed by Ed: countersunk. 2 per side into M5 sliding nuts on the top plate. | M5 x 8 countersunk | M5 T-nut
Gantry end, Y side (no homing arm): MGN9H block, plate, idler block – clamp top to bottom | Countersunk screw M3 x 8 | 1 | – |  | No | 7.03 | Confirmed by Ed: 1 per side. With the homing arm's 2, the X side has 3 of these screws and the Y side has 1. Idlers: a smooth one at the front and a toothed one (rounded D-shape) facing the back. | M3 x 8 countersunk
Gantry end, Y side – energy chain, on the underside where it connects to the bearing block | Countersunk screw M3 x 5 | 2 | – |  | No | 7.01 | Corrected by Ed: these are 2 x M3 x 5 countersunk (not M5). They separate from the 4 chain support screws. No M5 energy chain screws exist. | M3 x 5 countersunk
Gantry end, Y side (no homing arm): MGN9H block, plate, idler block – wiring | Cable tie, black | 1 | – |  | No | 5.04 | Per Ed: a single black cable tie holds and organises the wiring. | Cable tie, black
Gantry (X rail): MGN9 linear rail | Socket head (cap) screw M3 x 8 | 4 | M3 spring-ball T-slot nut (KJN43719) | 4 | No | 7.12, 7.14 | Per Ed. Brings M3 x 8 socket head to 12 in total with the Y rails, matching the old BOM's 12. | M3 x 8 socket head | M3 T-nut
Gantry underside: energy chain anti-sag clips (also clips for the terapixel lights, work in progress) | Countersunk screw M5 x 8 | 4 | M5 spring-ball T-slot nut (KJN37001) | 4 | No | 8.01, 8.07 | Per Ed (confirmed): 4 CHAIN_SUPPORT prints on the underside of the gantry, each held by an M5 x 8 countersunk screw with an M5 sliding nut. | M5 x 8 countersunk | M5 T-nut
Belt clamp – heat-set insert (rear of the tool head) | Heat-set insert M3 x 3 mm brass | 1 | – |  | No | 7.15 | Ed, 24 Oct: no inserts in the electronics tray after all; the only M3 insert is in the belt clamp, on the rear of the tool head. | M3 heat-set insert
Stepper tool head – carriage (stepper_tool_carriage.stl) onto the MGN9H block on the gantry | Countersunk screw M3 x 6 | 4 | – |  | No | 7.02 | Per Ed. | M3 x 6 countersunk
Stepper tool head – X optical endstop on the carriage | Button head screw M3 x 6 | 2 | – |  | No | 7.08 | Per Ed: M3 x 6 button head. Quantity of 2 assumed (same as the Y endstop): confirm. | M3 x 6 button head
Stepper tool head – energy chain attached to the top of the carriage | Countersunk screw M3 x 5 | 2 | – |  | No | 7.01 | Per Ed. | M3 x 5 countersunk
Stepper tool head – belt clamp (clamps the belt between two pieces) | Countersunk screw M3 x 5 | 1 | – |  | No | 7.01 | Per Ed: 'an M3 countersunk by 5'. Taken as 1 screw: confirm. | M3 x 5 countersunk
Stepper tool head – belt clamp fixed to the back of the head | Countersunk screw M3 x 6 | 2 | – |  | No | 7.02 | Per Ed. | M3 x 6 countersunk
Stepper tool head – tensioner | Countersunk screw M3 x 6 | 2 | – |  | No | 7.02 | Per Ed. | M3 x 6 countersunk
Stepper tool head – NEMA 14 motor to the carriage plate (Nema14mount2carriage.stl) | Countersunk screw M3 x 8 | 4 | – |  | No | 7.03 | Per Ed. What they thread into (the motor's tapped holes, presumably) is not noted. | M3 x 8 countersunk
Stepper tool head – extension spring holder, front of the plate, bottom left corner | Socket head (cap) screw M3 x 8 | 1 | None: into the plastic itself, or a heat-set insert if you use one |  | No | 7.12, 7.15, 9.04 | Per Ed: holds the 5.2 x 20.6 mm extension spring. Whether Ed uses an insert here is not stated: 'plastic itself, or an insert if you're using one'. | M3 x 8 socket head
Stepper tool head – 50 mm MGN7H rail and block on the plate | Socket head (cap) screw M2 x 8 | 3 | M2 heat-set insert in the plate | 3 | No | 6.02, 6.04 | Per Ed: 3 inserts on the plate itself, 3 screws. | M2 x 8 socket head | M2 heat-set insert
Stepper tool head – plate with MGN7H rail, mounted onto the tool head | Countersunk screw M3 x 8 | 4 | – |  | No | 7.03 | Per Ed. Separate from the 4 M3 x 8 that fix the NEMA 14 to the carriage plate. | M3 x 8 countersunk
Stepper tool head – pen holder onto the MGN7H block | Socket head (cap) screw M2 x 8 | 4 | – |  | No | 6.02 | Per Ed. Together with the 3 that fix the rail to the plate, M2 x 8 socket head comes to 7. | M2 x 8 socket head
Stepper tool head – spring, other end: rear of the pen holder, in a slot | Socket head (cap) screw M3 x 8 | 1 | M3 nyloc nut (A2 stainless, DIN 985), on the reverse side | 1 | No | 7.12, 7.13 | Per Ed: the screw sits in a slot with about 10 mm of travel, so the spring tension can be adjusted. Ed recommends mounting it at the bottom of the slot to begin with. The spring pulls the pen down towards the paper or bed. | M3 x 8 socket head | M3 nyloc nut
Stepper tool head – belt clamp on the pen holder (clamp bracket) | Countersunk screw M3 x 5 | 1 | – |  | No | 7.01 | Per Ed. Clamps about 30 mm of GT2 belt. 'An M3 countersunk by 5': taken as 1 screw: confirm. | M3 x 5 countersunk
Stepper tool head – belt pulley print (stepper belt pulley.stl) on the NEMA 14 shaft | None mentioned |  | – |  | – | 10.37 | Per Ed: the belt end goes into the print, which slots onto the D-shaft. No screw was mentioned: confirm there is none.
Stepper tool head – pen clip assembly (pen clip block, latch and link) | Countersunk screw M3 x 16 | 3 | None: into the plastic |  | No | 7.05 | Per Ed: 3 screws hold the clip assembly together. They go into pre-threaded plastic, or you screw them in to cut the thread. No nuts or inserts. | M3 x 16 countersunk
Electronics enclosure – with the Z-axis add-on (stacked Z board) | Button head screw M3 x 8 (replaces one of the board's M3 x 6) | 1 | – |  | No | 7.09 | Per Ed: the Z board is thick and stacks on the controller, so one of the 2 board button head screws is M3 x 8 instead of M3 x 6. Z add-on builds only. | M3 x 8 button head (Z add-on only)
Electronics enclosure – with the Z-axis add-on (stacked Z board) | Standoff M3 x 16 mm, male-female | 1 | – |  | No | 4.16 | Per Ed: a 16 mm standoff is needed in addition to the 18 mm ones, because the Z board is thick. Ed: just 1.

Sheet: Fixings totals
Fixings totals – from the walk-through (the 'real' figures, work in progress)
Counted from 'Fixings by part' as the build is walked through bottom frame upwards. The old BOM fixing quantities are shown only for comparison and are replaced once the walk-through is finished.
Fixing | Walk-through total so far | Old BOM qty (for comparison) | Notes
M3 x 16 button head (approx.) | 4 | 4 | Old BOM: M3 x 12 button head for the feet (7.10). Feet come with their screws.
M3 x 6 countersunk | 17 | 21 | Electronics cover (3) so far, plus the gantry blocks.
M3 x 6 button head | 6 | 4 | Controller board.
M3 standoff, male-female (about 18 mm) | 2 | 2 | Old BOM: nylon standoff M3 x 20.
M3 T-nut | 17 | 16 | Feet so far. You think about 13 in total.
M5 x 12 cap head | 12 | 22 | Bottom square 8 + legs 4 so far; top frame still to do.
M5 x 8 button head | 6 | 6 | L brackets 4 + electronics mount 2.
M5 x 8 countersunk | 33 | 18 | Includes the 4 chain support screws.
M5 T-nut | 43 | 50 | Placeholder 50 in the BOM.
M3 x 8 countersunk | 15 | 2 | Energy chain mount so far.
M3 x 30 countersunk | 4 | 4 | X motor so far (2 of 4).
M5 x 12 button head | 10 |  | Corner cube at the X motor so far.
M3 x 16 countersunk | 5 |  | X motor so far.
M5 x 20 countersunk | 6 | 4 | Idler bolts 2 + gantry 4 = 6 (Ed); the old BOM had 4.
M3 x 8 socket head | 14 | 12 | Y rails so far (8); the old 12 'frame – rails' probably includes 4 for the X rail.
Cable tie, black | 1 |  | Y-side wiring only so far.
M3 heat-set insert | 1 | 26 | Electronics tray so far (5). The old BOM had 26 for all printed parts, a pack of 50 at £5.90.
M3 x 5 countersunk | 6 | 11 | Y gantry underside (energy chain) so far.
M2 x 8 socket head | 7 |  | MGN7H rail 3 + pen holder 4 so far.
M2 heat-set insert | 3 | 4 | Plate inserts so far.
M3 nyloc nut | 2 | 2 | Z tool head: spring so far (1).
M3 x 8 button head (Z add-on only) | 1 |  | Z add-on builds only.

Sheet: Cable leads
Cable leads
Cut and strip details for each lead. Also the source for the build documentation.
Lead | Cores | AWG | Sheath | Length (mm) | Strip at motor end (mm) | Strip at controller end (mm) | Connectors | Notes
Y motor | 4 | 24 | PVC, flexible, unshielded | 515 | 27-30 | 17-20 | Controller end: JST PH 2.0 4-way. Motor end: JST PH 2.0 6-way, cores in positions 1, 3, 4 and 6 (2 and 5 empty). | Shielded cable is tricky for this lead because it needs to flex. Core colours on your cable: yellow, blue, green, red (varies by supplier). Colour-to-pin mapping still to document.
X motor | 4 | 24 | PVC, flexible, unshielded | 920 | 27-30 | 17-20 | Controller end: JST PH 2.0 4-way. Motor end: JST PH 2.0 6-way, cores in positions 1, 3, 4 and 6 (2 and 5 empty). | Same as the Y lead except for length. Core colours on your cable: yellow, blue, green, red (varies by supplier). Colour-to-pin mapping still to document.
X endstop | 3 x single core | 26 | None: 3 loose single cores (Alpha Wire 3049 BK001), colour-taped at both ends | 2100 | to confirm | to confirm | Female JST SM on the wire (pitch to confirm; JST SM is normally 2.5 mm) plugs into the male on the endstop module. Controller end: JST PH 2.0 3-way (assumed). | POLARITY: match the lead's wire order to the board header and the module pins (module is SIG / GND / VCC). Runs through the 7 x 7 energy chain, hence single cores. Same length as the Z lead. Pin order on both ends still to document.
Y endstop | 3 | 26 (confirm) | PVC | 920 | to confirm | to confirm | Female JST SM on the wire (pitch to confirm; JST SM is normally 2.5 mm) plugs into the male on the endstop module. Controller end: JST PH 2.0 3-way (assumed). | POLARITY: match the lead's wire order to the board header and the module pins (module is SIG / GND / VCC). Same length as the X motor lead (920 mm), where it is housed next to the motor. Sheathed 3-core assumed since it doesn't go through the energy chain; confirm.
Z motor | 4 x single core | 26 | None: 4 loose single cores (Alpha Wire 3049 BK001, black PVC, tinned copper), colour-taped at both ends | 2100 | – | – | Motor end: female JST SM, mating with a male JST SM fitted to the NEMA 14's lead (cut to 30-40 mm from the motor). Controller end: white JST PH 2.0 4-way, pins 1 to 4 all used. | Runs through the 7 x 7 energy chain, hence single cores. Tape a thin strip of a different colour on both ends of each wire (e.g. red on both ends of one, green on both ends of another). 2100 mm leaves a little slack.
