theworkisthework/terraPen-mechanical-design-files/metal bed/tP_Bed_Profile_Revised.dxf

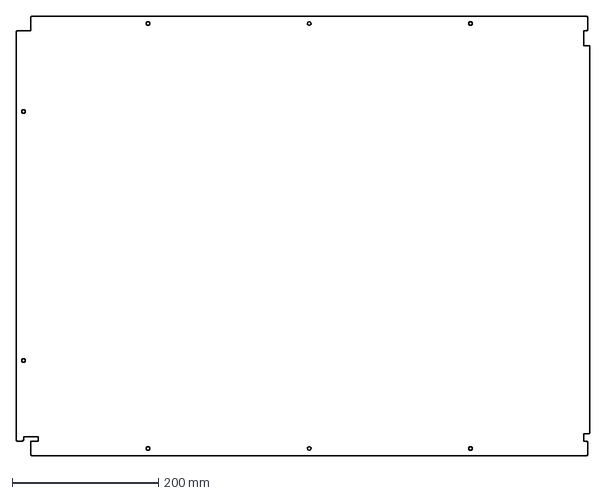
[picture p1: CAD file, 2026-10-01]
metal bed/tP_Bed_Profile_Revised.dxf
783.0 x 600.0 mm
