theworkisthework/terraPen-mechanical-design-files/Stepper_Z_Axis_Experimental/Pen Holder Insert.FCStd

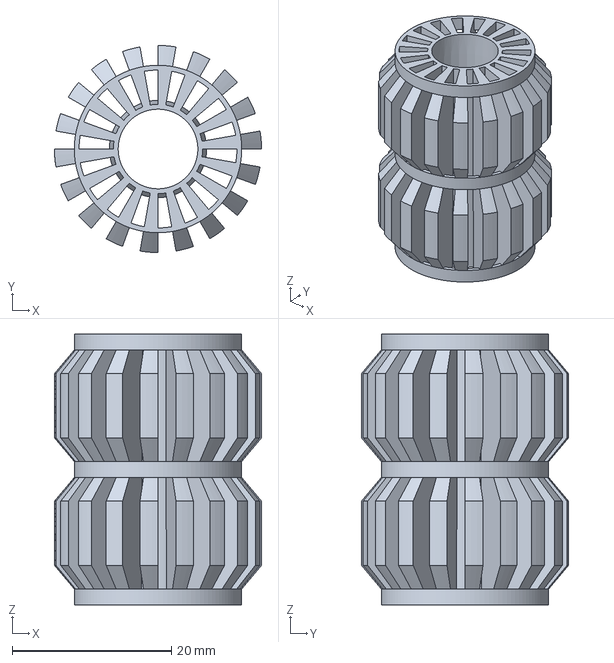
[picture p2: CAD file, 2025-07-17]
Stepper_Z_Axis_Experimental/Pen Holder Insert.FCStd
26.0 x 26.0 x 34.0 mm
