theworkisthework/terraPen-mechanical-design-files/STLs/D_Line_20x10_Flat_corner.stl

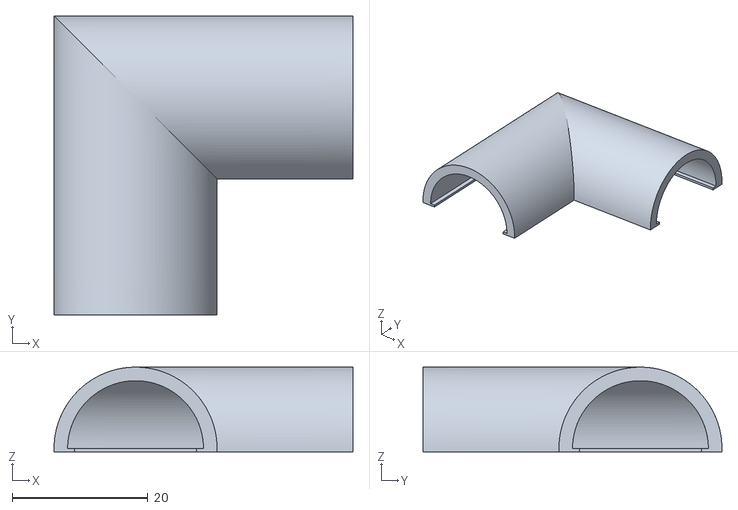
[picture p3: CAD file, 2026-10-24]
STLs/D_Line_20x10_Flat_corner.stl
44.0 x 44.0 x 12.5
