theworkisthework/terraPen-mechanical-design-files/STLs/TPU Bungs/Apature Bungs TPU Strength 0_4.3mf

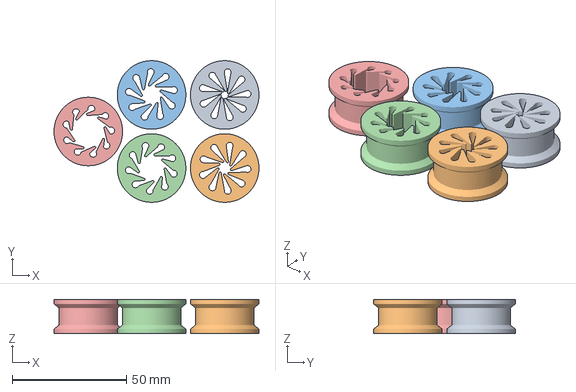
[picture p4: CAD file, 2026-10-12]
STLs/TPU Bungs/Apature Bungs TPU Strength 0_4.3mf
89.7 x 62.0 x 15.0 mm
