theworkisthework/terraPen-mechanical-design-files/terraPenA2.step

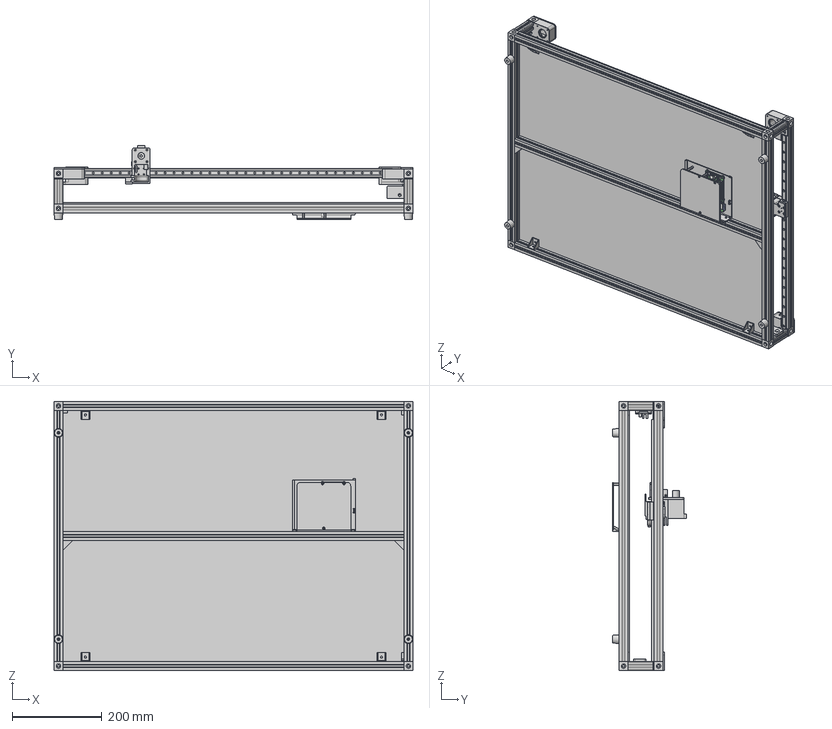
[picture p5: CAD file, 2026-10-01]
terraPenA2.step
800.2 x 165.5 x 600.0 mm
RubberFoot v2
Y_Motor_Mount v2
Y_Idler_Bottom
Y_Idler_Top
X_Idler_Bottom
X_Idler_Top
XY DeepDish Bottom
CY DeepDish Top
MGN9H_NEW v1 (2)
2020AluminiumExtrusion760 v2
stand offs
Endstop mount
XY_Endstop_Pegger
IdlerToothed x 8
IdlerSmooth x 4
2020CornerCube v3 (6)
2020CornerCube v3 (7)
2020CornerCube v3 (5)
2020CornerCube v3 (4)
2020CornerCube v3 (3)
2020CornerCube v3 (2)
2020CornerCube v3 (1)
2020CornerCube v3
90degCorner v1 x 6
2020AluminiumExtrusion760 v2_1
2020AluminiumExtrusion760 v2 (1)
2020AluminiumExtrusion760 v2 (2)
2020AluminiumExtrusion760 v2 (3)
2020AluminiumExtrusion760 v2 (4)
2020AluminiumExtrusion760 v2 (5)
2020AluminiumExtrusion760 v2 (6)
2020AluminiumExtrusion710 v1
2020AluminiumExtrusion40 v2
MGN9_Rail_540 v1
MGN9_Rail_540 v1 (1)
MGN9_Rail_710 v1
MGN9H_NEW v1
MGN9H_NEW v1 (1)
6000N501_T-Slotted Framing Fasteners x 20
5278N42_T-Slotted Framing Fasteners x 2
T-Nut M5 v1(Mirror) x 14
5278N42_T-Slotted Framing Fasteners_1 x 2
Chain support
A5 terraPen_RAIL_U_MOUNT (1) v4 v30
Nema14
pen lift plate
Pen holder belt clamp
Drive belt pulley
YX Bottom DeepDish
YX Top DeepDish
X_Motor_Top_Deepdish
X_Motor_Bottom_Deepdish
YMotorDeepDish
