theworkisthework/terraPen-mechanical-design-files/STLs/CHAIN_SUPPORT.stl

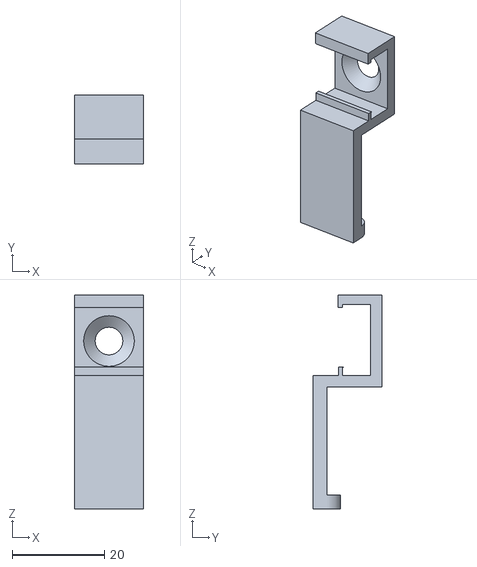
[picture p6: CAD file, 2026-10-23]
STLs/CHAIN_SUPPORT.stl
15.0 x 15.0 x 46.5
