theworkisthework/terraPen-mechanical-design-files/STLs/8xTPU_Bumper.3mf

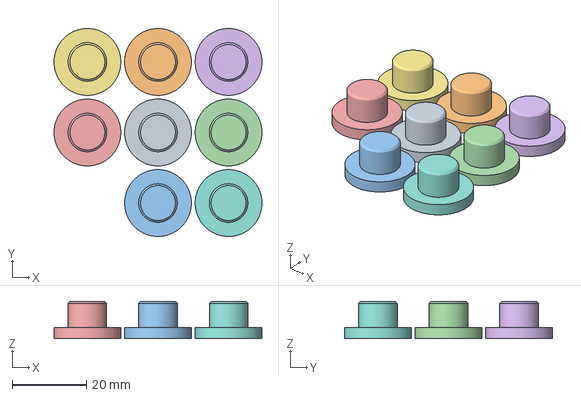
[picture p8: CAD file, 2026-10-12]
STLs/8xTPU_Bumper.3mf
56.0 x 56.0 x 10.0 mm
8xTPU_Bumper.stl x 8
