theworkisthework/terraPen-mechanical-design-files/STLs/Cable Cap for Extrusion.stl

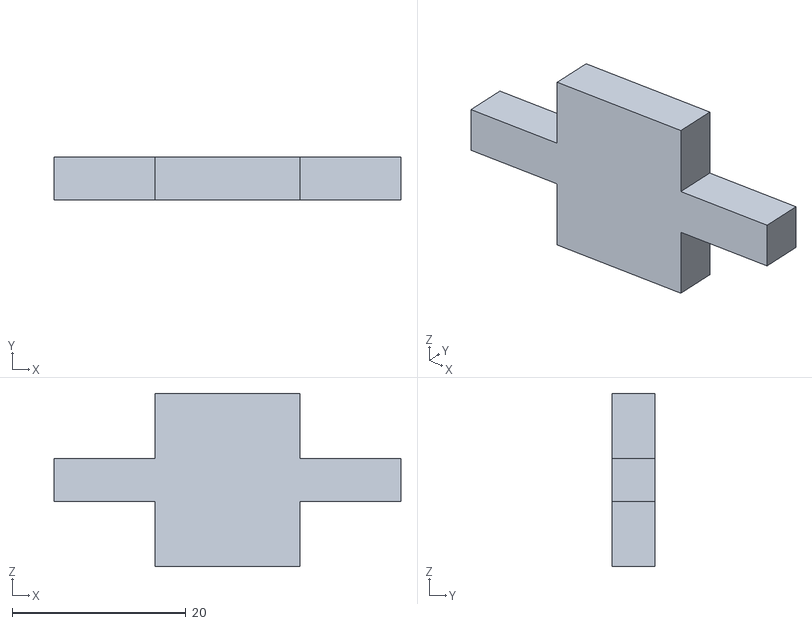
[picture p10: CAD file, 2026-10-12]
STLs/Cable Cap for Extrusion.stl
40.0 x 5.00 x 20.0
