theworkisthework/terraPen-mechanical-design-files/STLs/TPU Bungs/aperture bung.FCStd

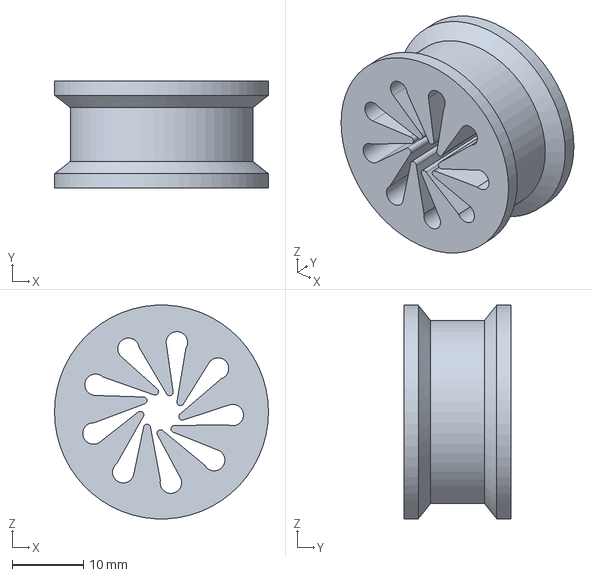
[picture p11: CAD file, 2025-07-17]
STLs/TPU Bungs/aperture bung.FCStd
30.0 x 15.0 x 30.0 mm
