theworkisthework/terraPen-mechanical-design-files/STLs/TPU Bungs/9mm Aperture Bung.3mf

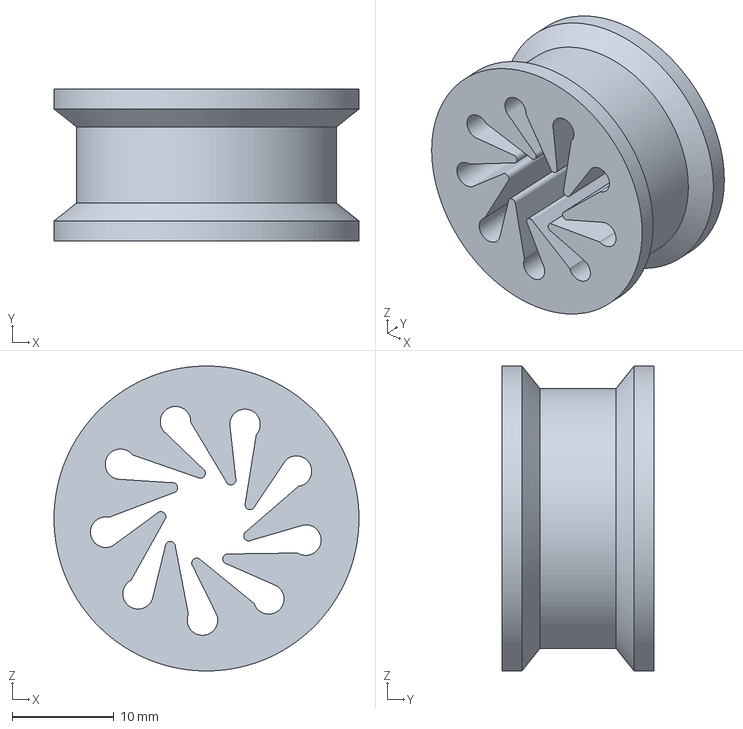
[picture p12: CAD file, 2025-07-17]
STLs/TPU Bungs/9mm Aperture Bung.3mf
30.0 x 15.0 x 30.0 mm
