theworkisthework/terraPen-mechanical-design-files/STLs/Y Endstop mount.stl

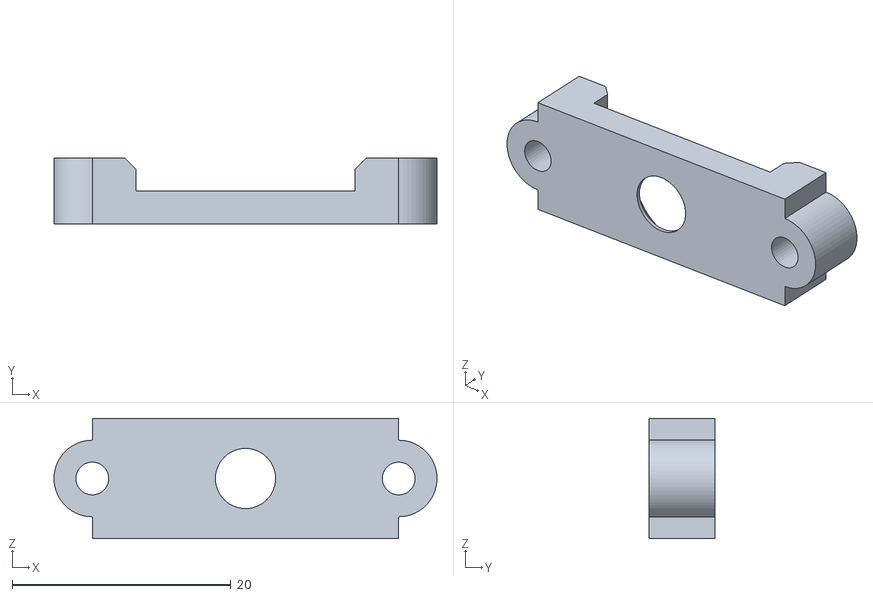
[picture p13: CAD file, 2026-10-01]
STLs/Y Endstop mount.stl
35.0 x 6.00 x 11.0
