theworkisthework/terraPen-mechanical-design-files/STLs/Y_Motor_Bottom.stl

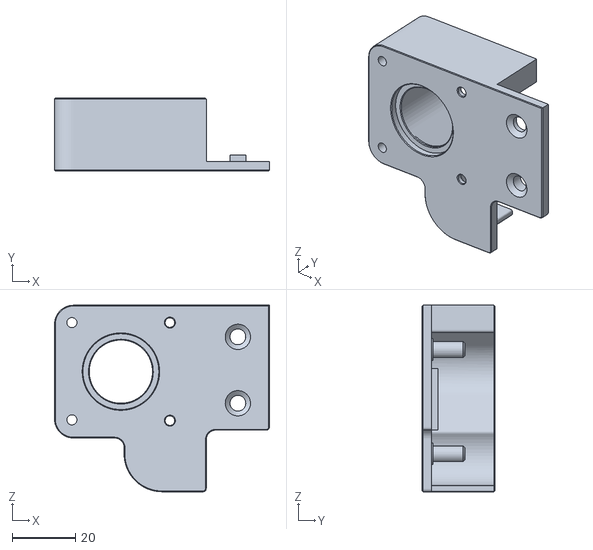
[picture p14: CAD file, 2026-10-01]
STLs/Y_Motor_Bottom.stl
68.0 x 23.0 x 59.0
