theworkisthework/terraPen-mechanical-design-files/STLs/stepper_tool_carriage.stl

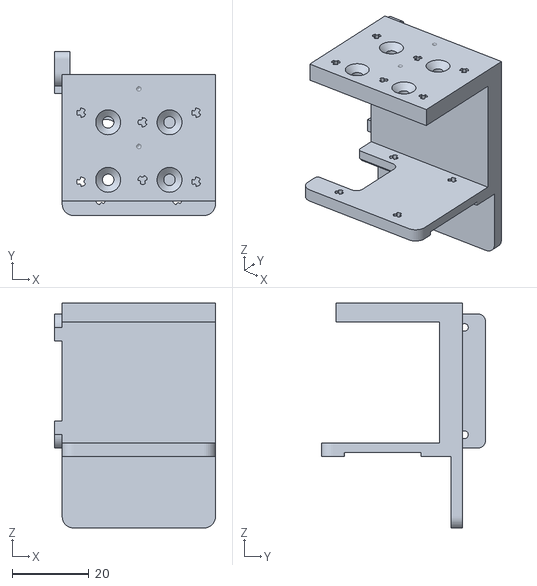
[picture p15: CAD file, 2026-10-01]
STLs/stepper_tool_carriage.stl
42.0 x 42.8 x 58.7
