theworkisthework/terraPen-mechanical-design-files/STLs/TPU Bungs/4mm Aperture Bung.3mf

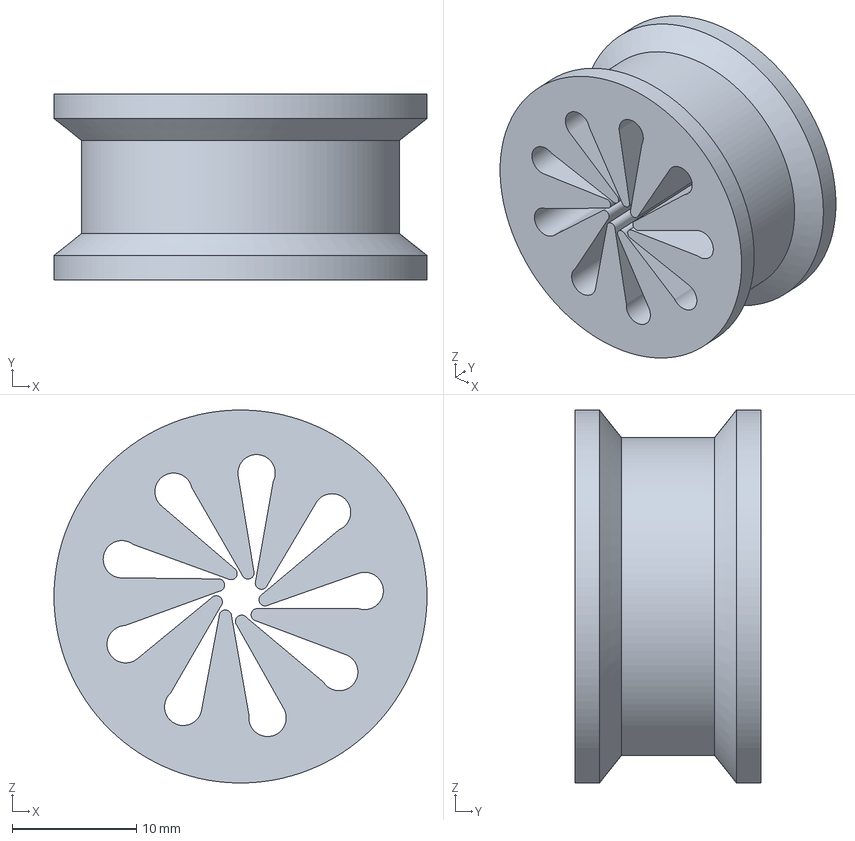
[picture p16: CAD file, 2025-07-17]
STLs/TPU Bungs/4mm Aperture Bung.3mf
30.0 x 15.0 x 30.0 mm
