theworkisthework/terraPen-mechanical-design-files/STLs/stepper_pen_mount_clamp.stl

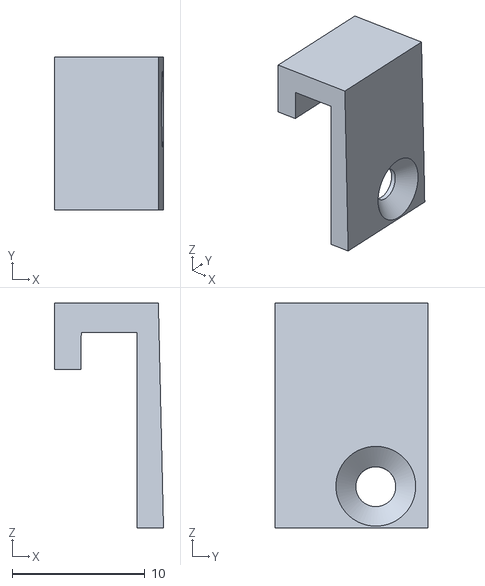
[picture p17: CAD file, 2026-10-01]
STLs/stepper_pen_mount_clamp.stl
8.20 x 11.5 x 16.9
