theworkisthework/terraPen-mechanical-design-files/STLs/TPU Bungs/8mm Tapered Bung.stl

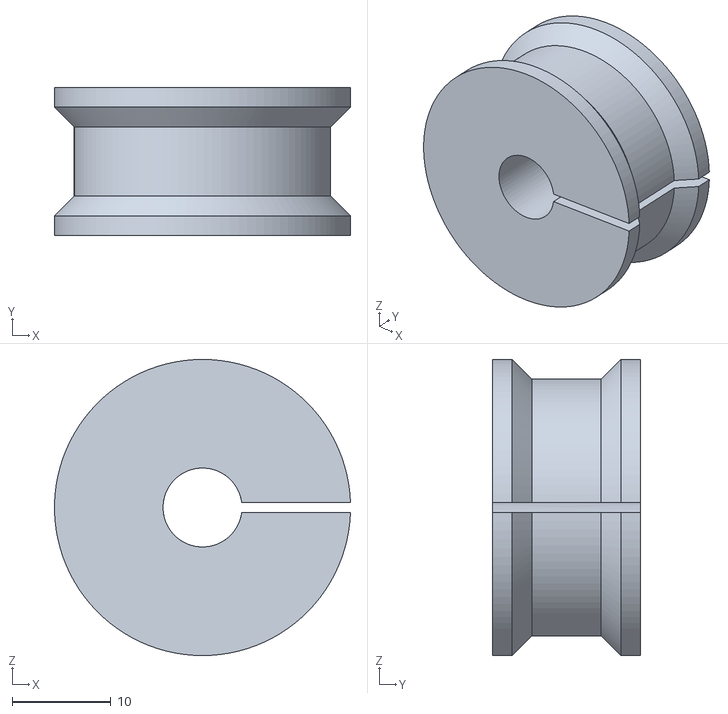
[picture p18: CAD file, 2025-02-08]
STLs/TPU Bungs/8mm Tapered Bung.stl
30.0 x 15.0 x 30.0
