theworkisthework/terraPen-mechanical-design-files/STLs/X_Motor_Bottom.stl

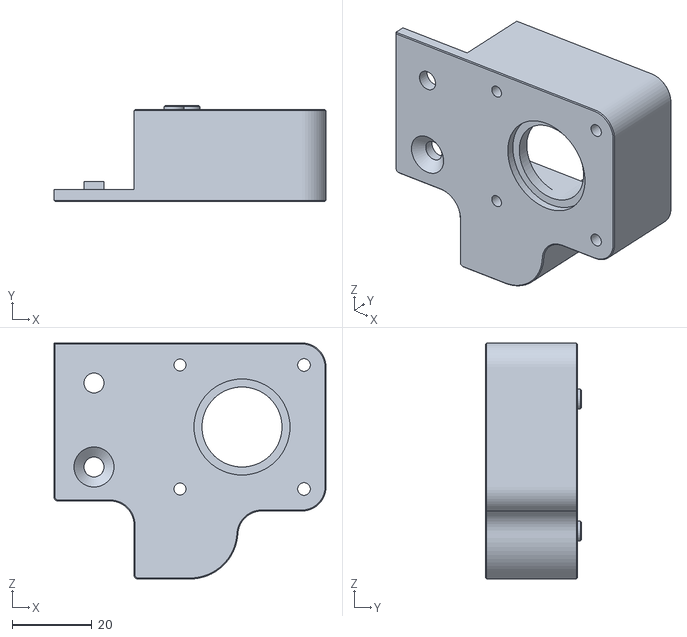
[picture p20: CAD file, 2026-10-01]
STLs/X_Motor_Bottom.stl
68.0 x 24.0 x 59.0
