theworkisthework/terraPen-mechanical-design-files/STLs/X_Idler_Top_clamped.stl

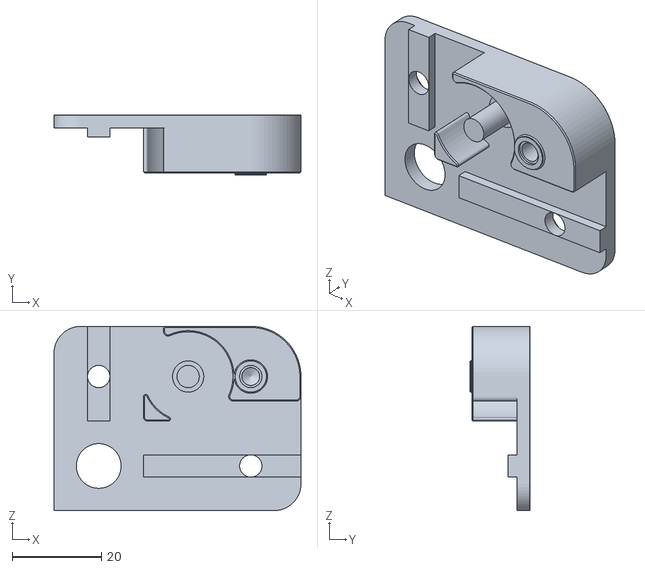
[picture p21: CAD file, 2026-10-01]
STLs/X_Idler_Top_clamped.stl
55.2 x 13.5 x 41.2
