theworkisthework/terraPen-mechanical-design-files/STLs/stepper belt pulley.stl

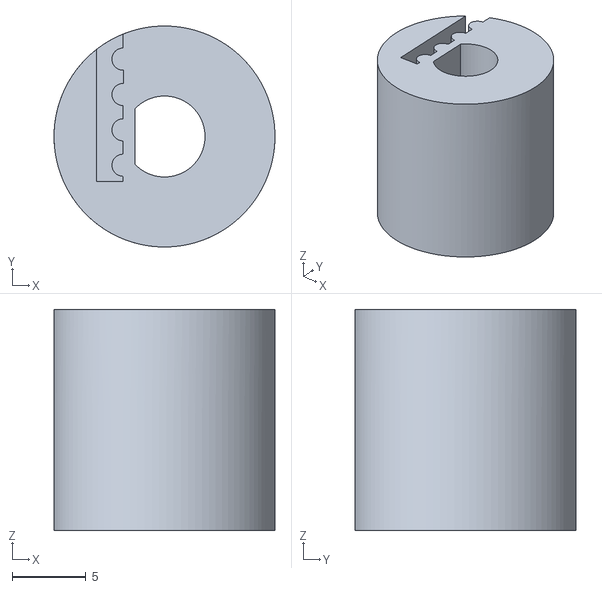
[picture p22: CAD file, 2026-10-01]
STLs/stepper belt pulley.stl
15.0 x 15.0 x 15.0
