theworkisthework/terraPen-mechanical-design-files/STLs/Y_Idler_Bottom_clamped.stl

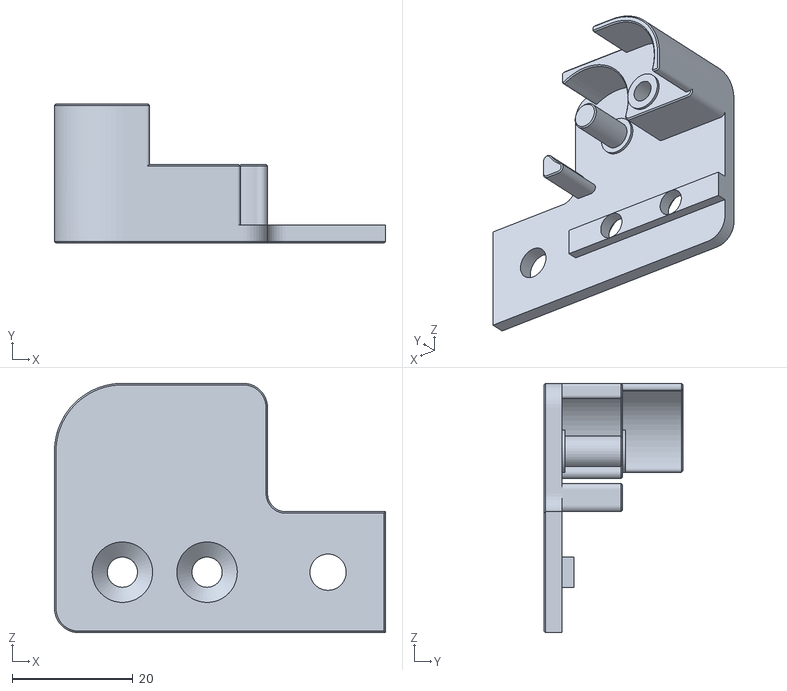
[picture p23: CAD file, 2026-10-01]
STLs/Y_Idler_Bottom_clamped.stl
54.7 x 23.0 x 41.2
