theworkisthework/terraPen-mechanical-design-files/STLs/stepper_pen_mount.stl

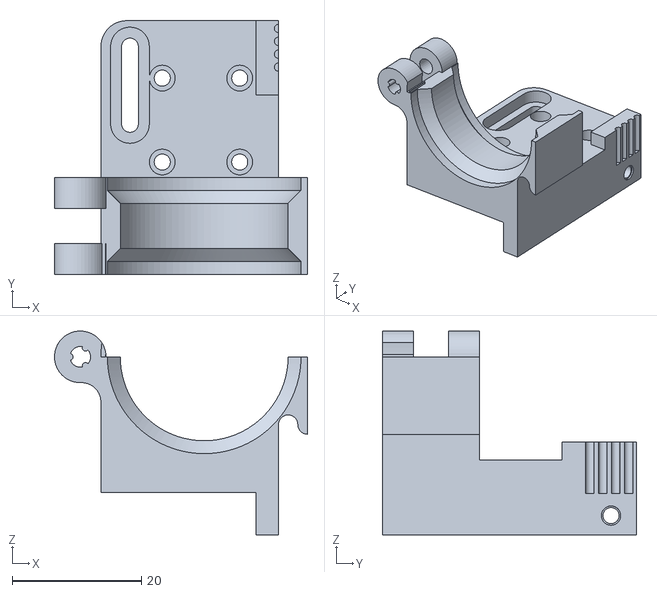
[picture p24: CAD file, 2026-10-01]
STLs/stepper_pen_mount.stl
39.2 x 39.3 x 31.6
