theworkisthework/terraPen-mechanical-design-files/STLs/Y_Idler_Top._clamped.stl

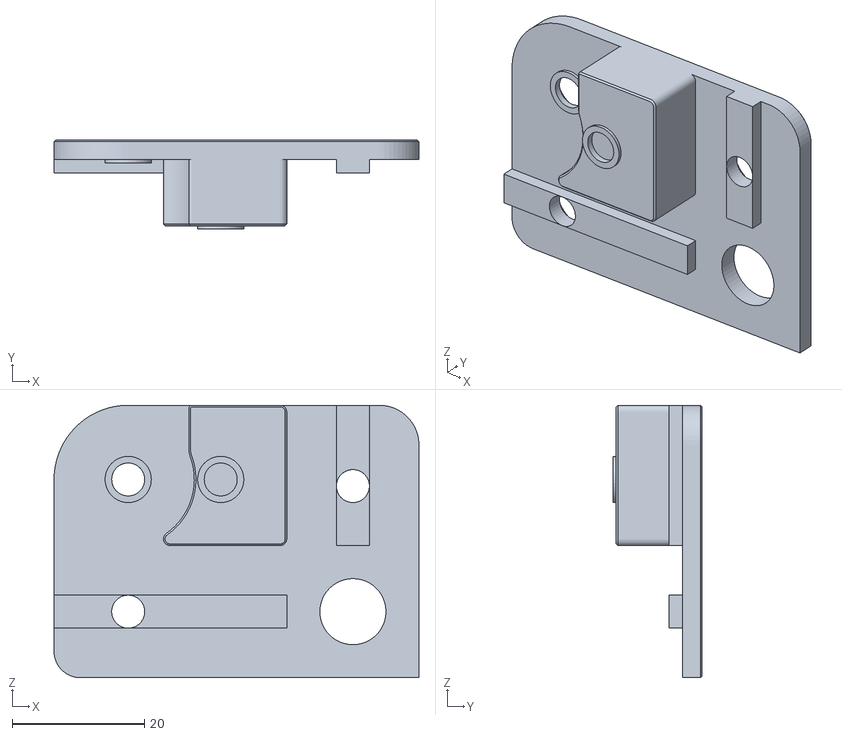
[picture p25: CAD file, 2026-10-01]
STLs/Y_Idler_Top._clamped.stl
55.2 x 13.5 x 41.2
