theworkisthework/terraPen-mechanical-design-files/STLs/X_Idler_Bottom_clamped.stl

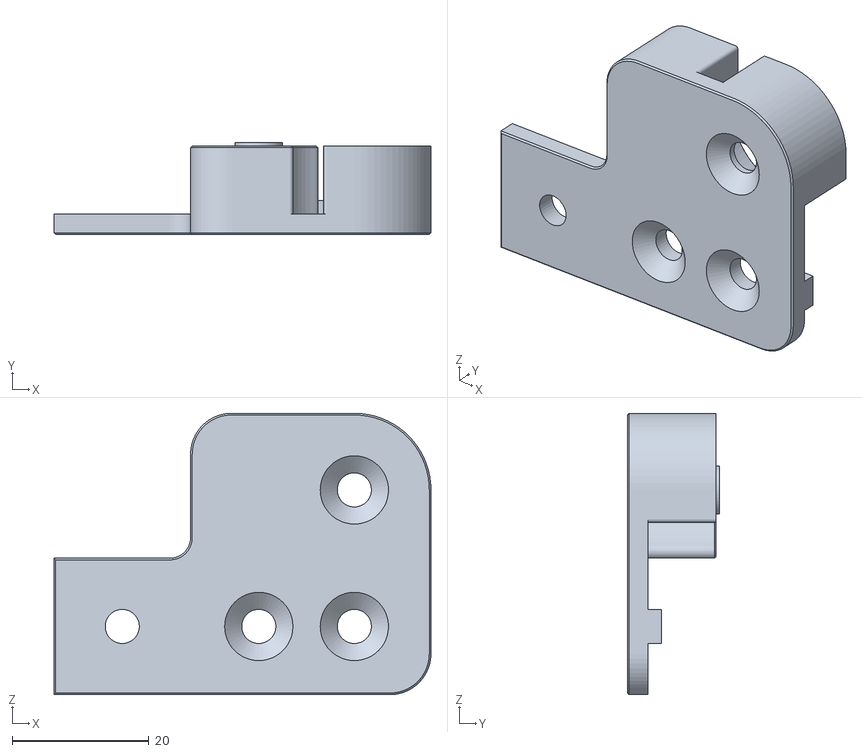
[picture p26: CAD file, 2026-10-01]
STLs/X_Idler_Bottom_clamped.stl
55.2 x 13.5 x 41.2
