theworkisthework/terraPen-mechanical-design-files/STLs/Nema14mount2carriage.stl

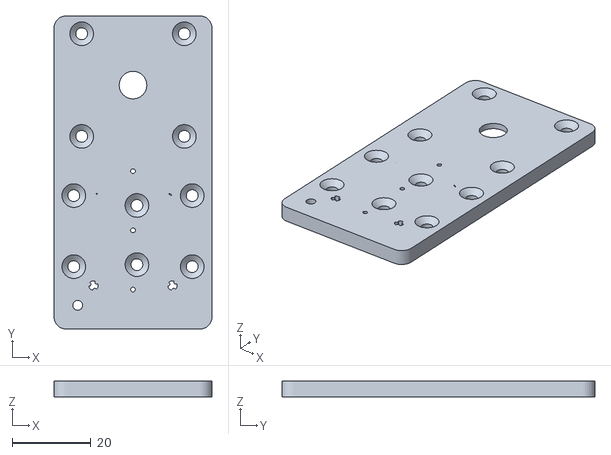
[picture p27: CAD file, 2026-10-01]
STLs/Nema14mount2carriage.stl
40.0 x 79.3 x 4.00
