theworkisthework/terraPen-mechanical-design-files/STLs/Y_Motor_Top.stl

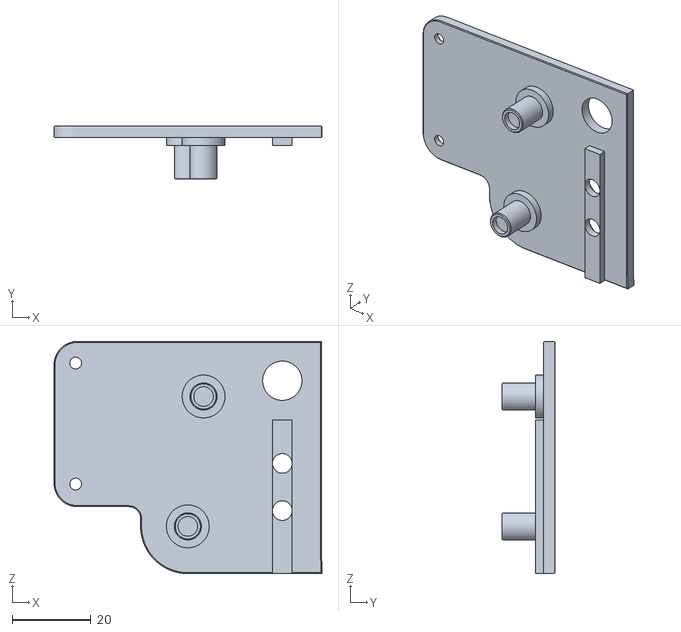
[picture p28: CAD file, 2025-07-17]
STLs/Y_Motor_Top.stl
68.1 x 13.5 x 59.0
