theworkisthework/terraPen-mechanical-design-files/STLs/Y_Idler_Bottom.stl

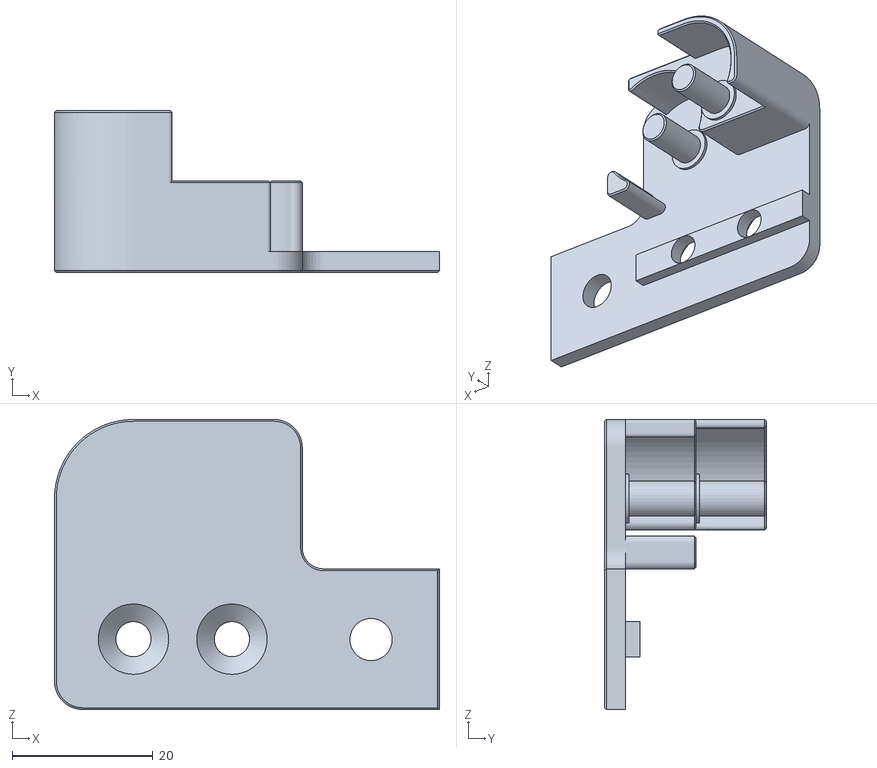
[picture p29: CAD file, 2025-07-17]
STLs/Y_Idler_Bottom.stl
54.7 x 23.0 x 41.2
