theworkisthework/terraPen-mechanical-design-files/STLs/Pen_Clip_Latch.stl

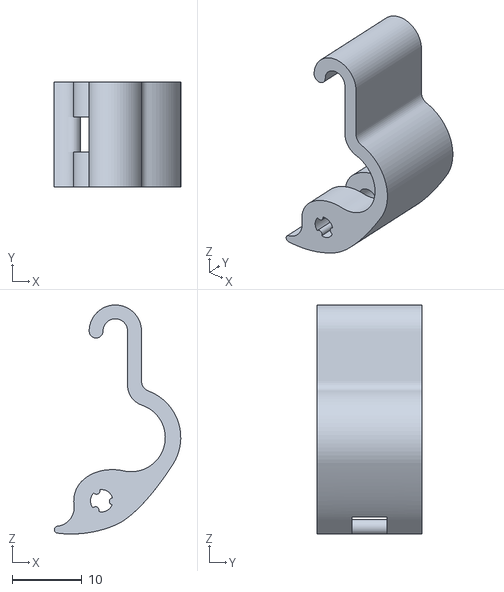
[picture p30: CAD file, 2025-07-17]
STLs/Pen_Clip_Latch.stl
18.1 x 15.0 x 32.8
