theworkisthework/terraPen-mechanical-design-files/STLs/Power_Enclosure_Back.stl

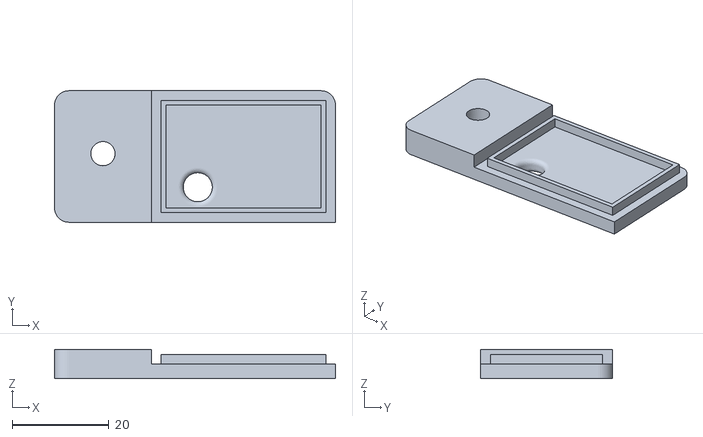
[picture p31: CAD file, 2025-07-17]
STLs/Power_Enclosure_Back.stl
58.0 x 27.2 x 6.00
