theworkisthework/terraPen-mechanical-design-files/STLs/Tensioner_Housing.stl

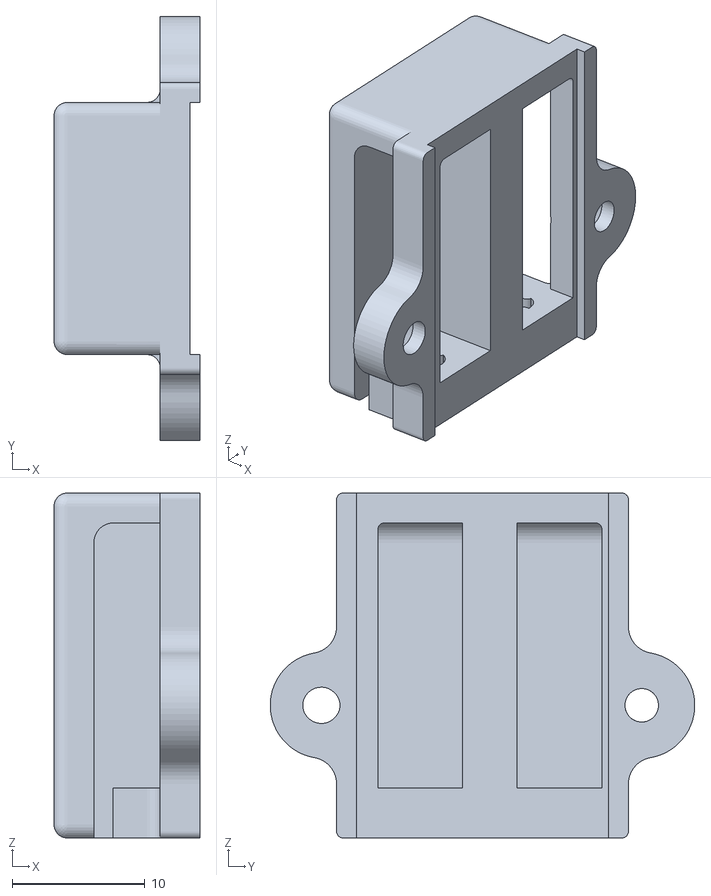
[picture p32: CAD file, 2025-07-17]
STLs/Tensioner_Housing.stl
11.0 x 32.0 x 26.0
