theworkisthework/terraPen-mechanical-design-files/STLs/X_Idler_Bottom.stl

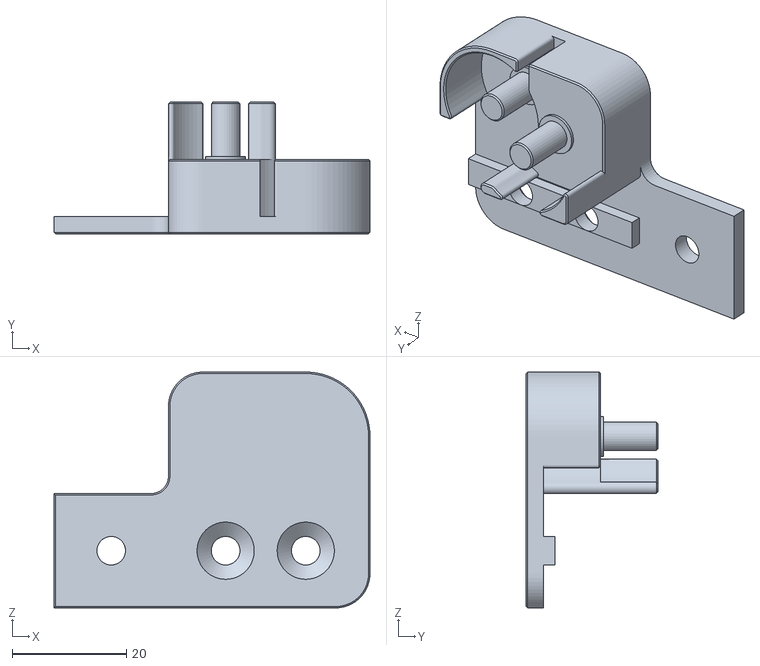
[picture p33: CAD file, 2025-07-17]
STLs/X_Idler_Bottom.stl
55.2 x 23.0 x 41.2
