theworkisthework/terraPen-mechanical-design-files/STLs/Pen_Clip_Link.stl

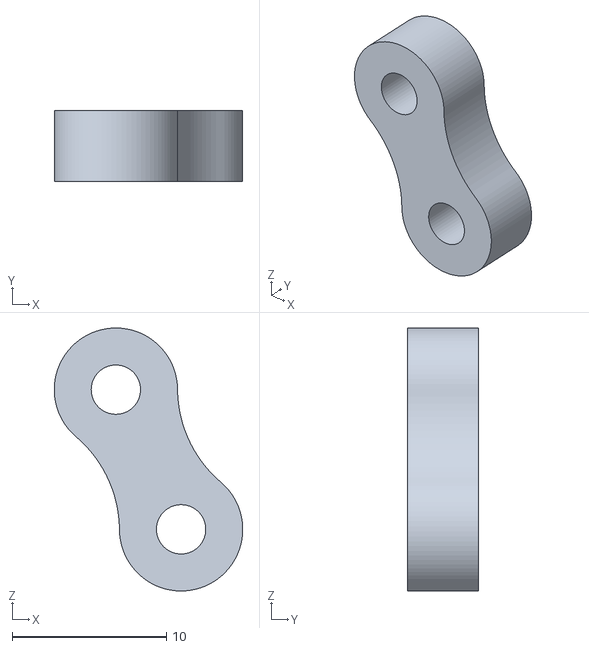
[picture p34: CAD file, 2025-07-17]
STLs/Pen_Clip_Link.stl
12.2 x 4.60 x 17.1
