theworkisthework/terraPen-mechanical-design-files/STLs/Solenoid_Mounting_Bracket.stl

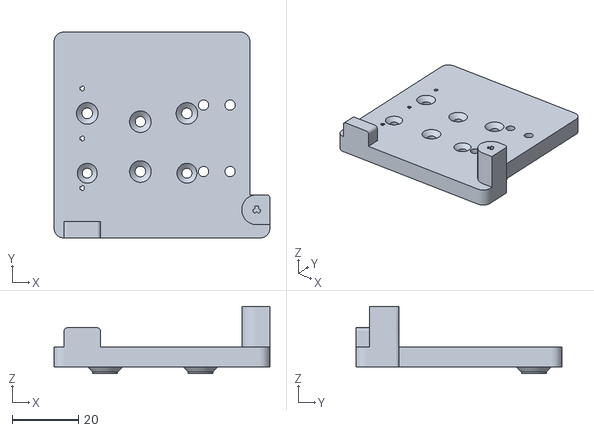
[picture p35: CAD file, 2025-07-17]
STLs/Solenoid_Mounting_Bracket.stl
65.0 x 62.0 x 20.2
