theworkisthework/terraPen-mechanical-design-files/STLs/Pen_Holder_Front.stl

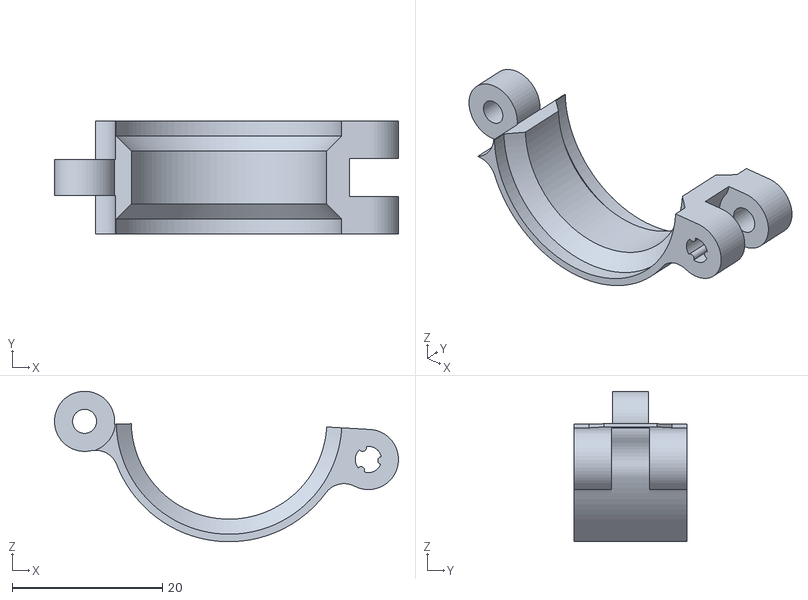
[picture p37: CAD file, 2025-07-17]
STLs/Pen_Holder_Front.stl
45.7 x 15.0 x 20.0
