theworkisthework/terraPen-mechanical-design-files/STLs/Xx_Carraiage_Bottom.stl

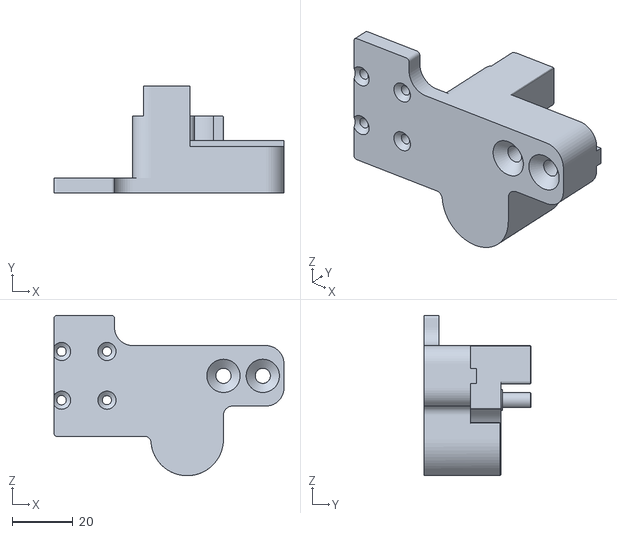
[picture p38: CAD file, 2025-07-17]
STLs/Xx_Carraiage_Bottom.stl
76.0 x 35.5 x 53.0
