theworkisthework/terraPen-mechanical-design-files/STLs/X_Idler_Top.stl

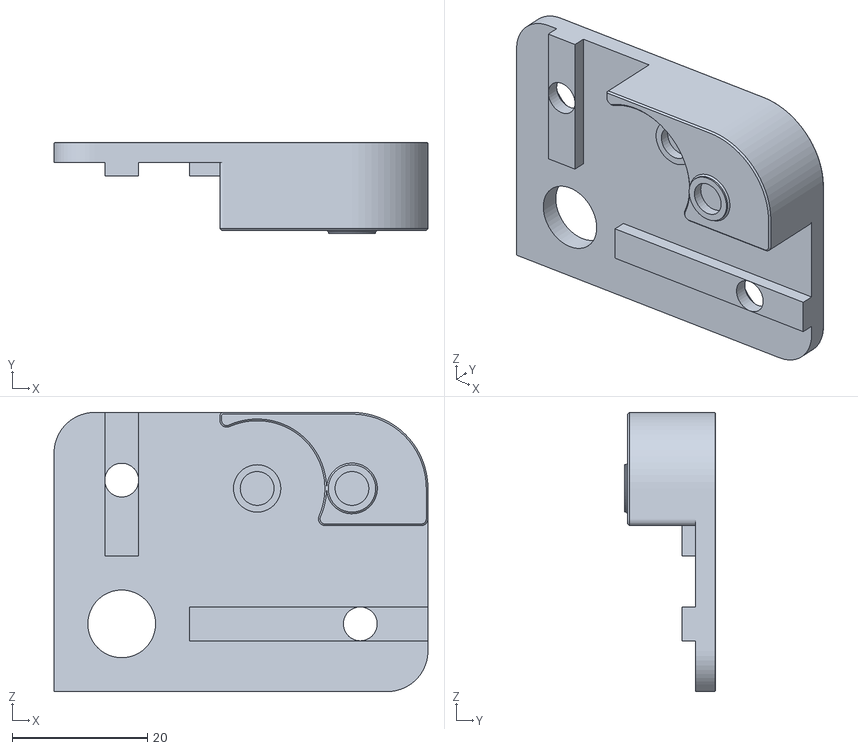
[picture p39: CAD file, 2025-07-17]
STLs/X_Idler_Top.stl
55.2 x 13.5 x 41.2
