theworkisthework/terraPen-mechanical-design-files/STLs/Xy_Carriage_Bottom.stl

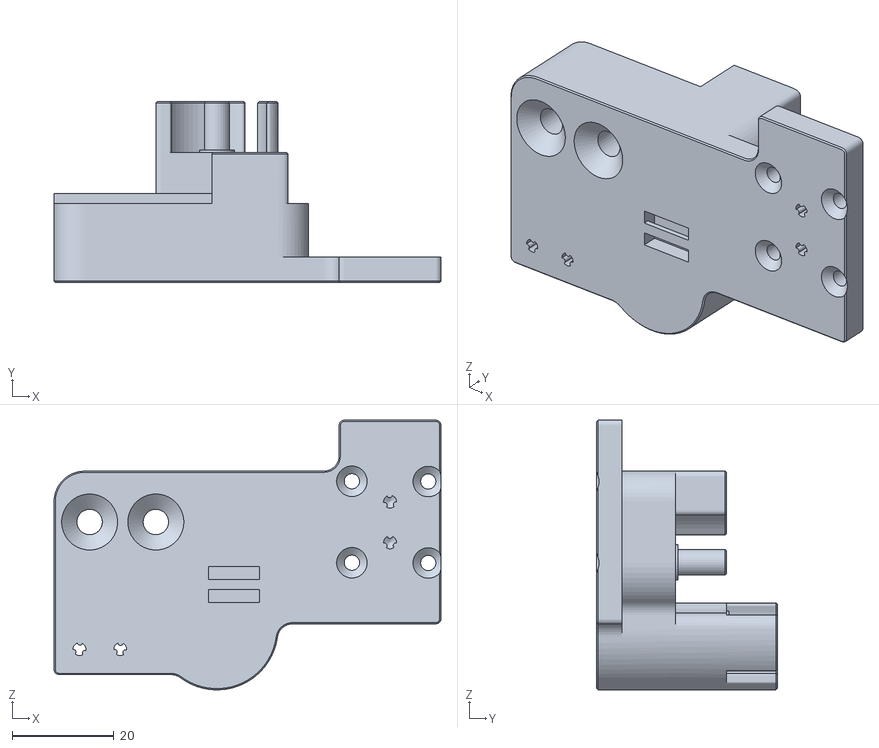
[picture p40: CAD file, 2025-07-17]
STLs/Xy_Carriage_Bottom.stl
76.0 x 35.5 x 53.0
