theworkisthework/terraPen-mechanical-design-files/STLs/Belt_Clamp_Teeth.stl

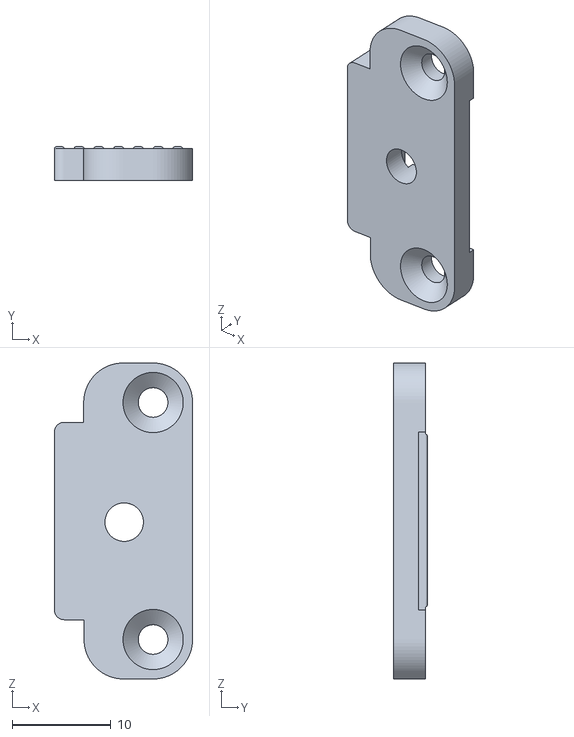
[picture p41: CAD file, 2025-07-17]
STLs/Belt_Clamp_Teeth.stl
14.0 x 3.40 x 32.0
