theworkisthework/terraPen-mechanical-design-files/STLs/Power_Enclosure_Box.stl

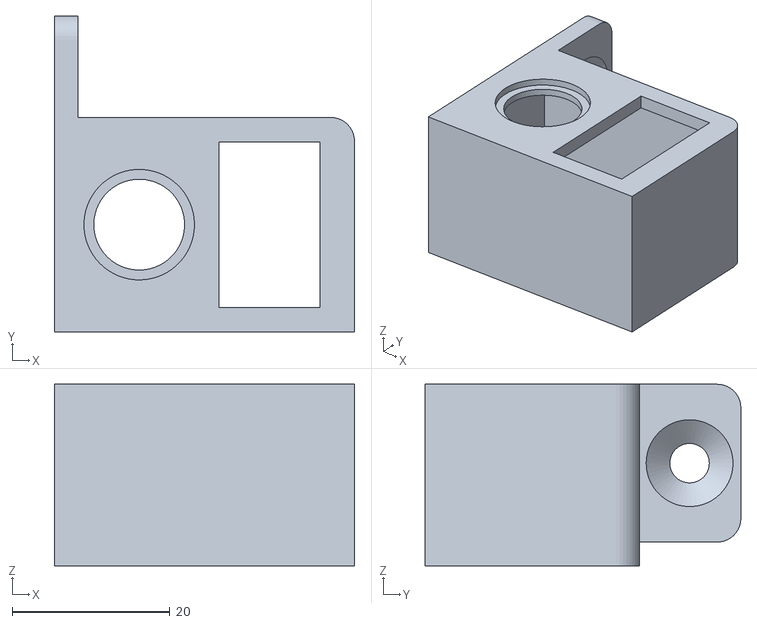
[picture p43: CAD file, 2025-07-17]
STLs/Power_Enclosure_Box.stl
38.0 x 40.0 x 23.0
