theworkisthework/terraPen-mechanical-design-files/STLs/Xx_Carriage_Top.stl

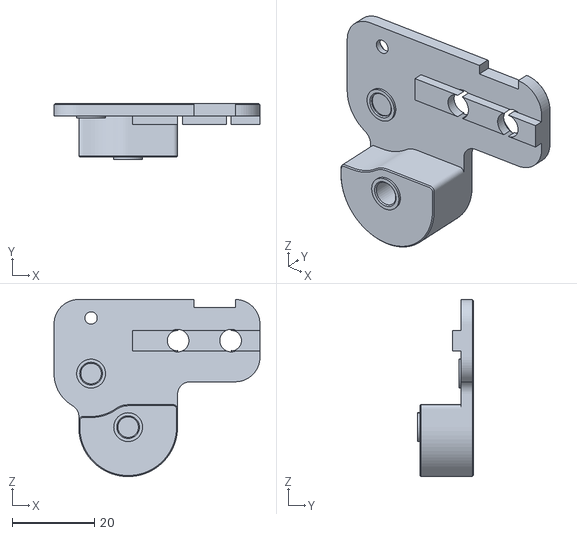
[picture p44: CAD file, 2025-07-17]
STLs/Xx_Carriage_Top.stl
50.0 x 13.5 x 43.0
