theworkisthework/terraPen-mechanical-design-files/STLs/Tool_Carriage.stl

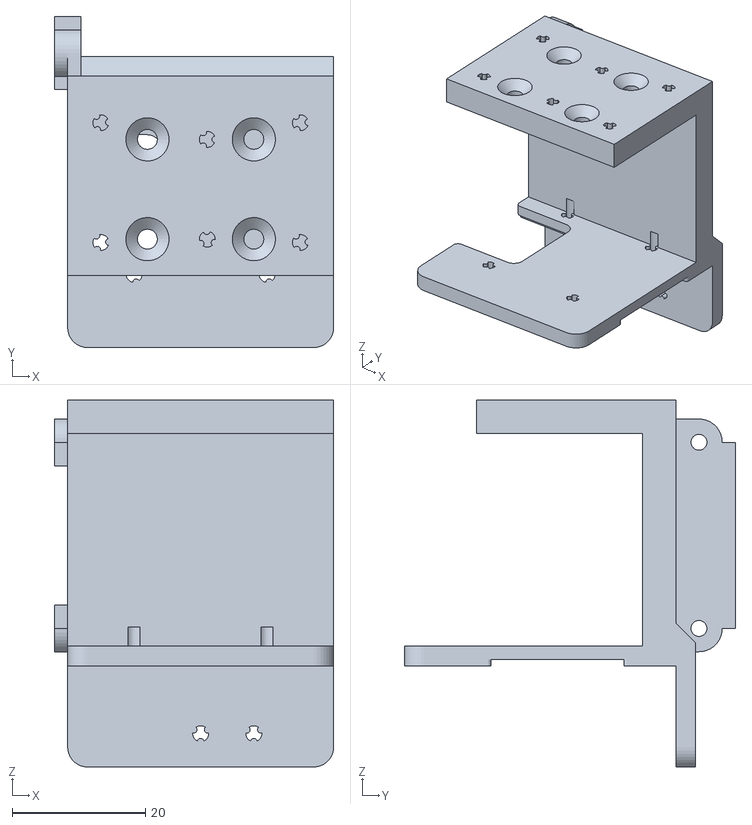
[picture p45: CAD file, 2025-07-17]
STLs/Tool_Carriage.stl
42.0 x 49.8 x 55.2
