theworkisthework/terraPen-mechanical-design-files/STLs/Pen_Clip_Block.stl

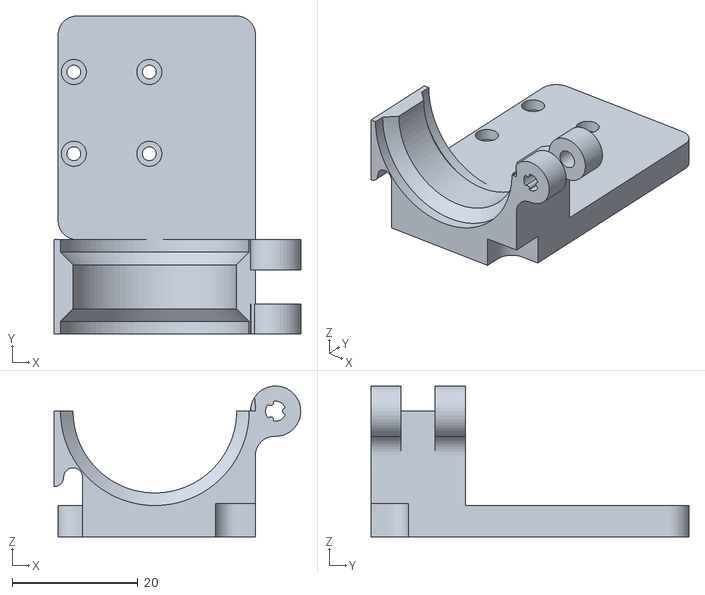
[picture p46: CAD file, 2025-07-17]
STLs/Pen_Clip_Block.stl
39.2 x 50.6 x 24.0
