theworkisthework/terraPen-mechanical-design-files/STLs/Electronics Enclosure.stl

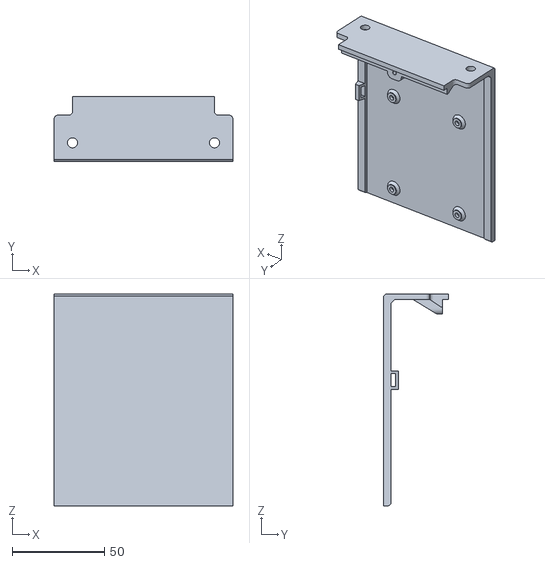
[picture p47: CAD file, 2025-07-17]
STLs/Electronics Enclosure.stl
97.0 x 35.0 x 115.0
