theworkisthework/terraPen-mechanical-design-files/STLs/Servo_Pen_Holder.stl

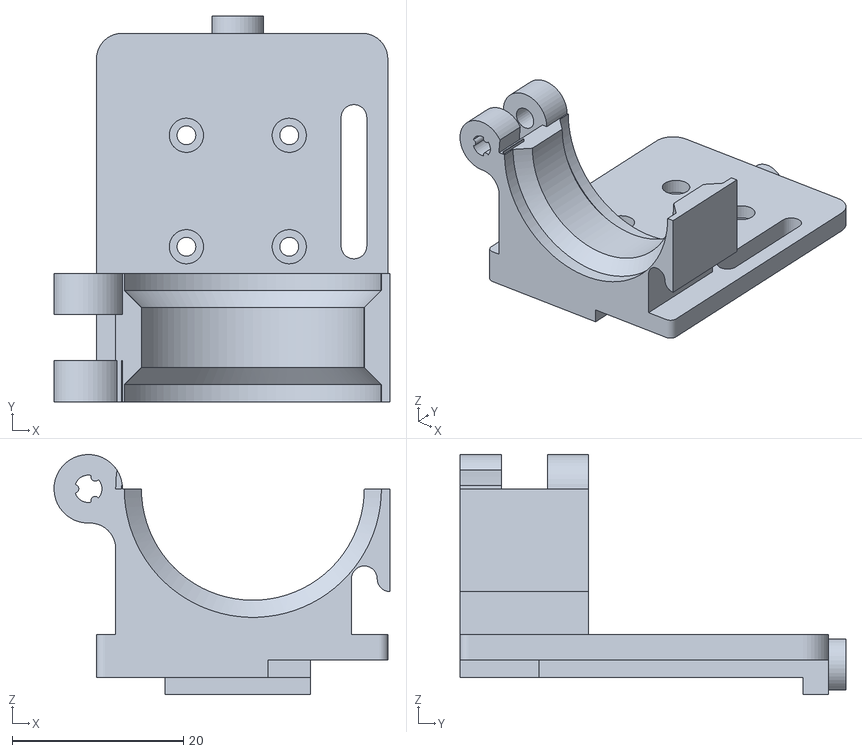
[picture p48: CAD file, 2025-07-17]
STLs/Servo_Pen_Holder.stl
39.2 x 45.0 x 28.0
