theworkisthework/terraPen-mechanical-design-files/STLs/Xx_Endstop_Top .stl

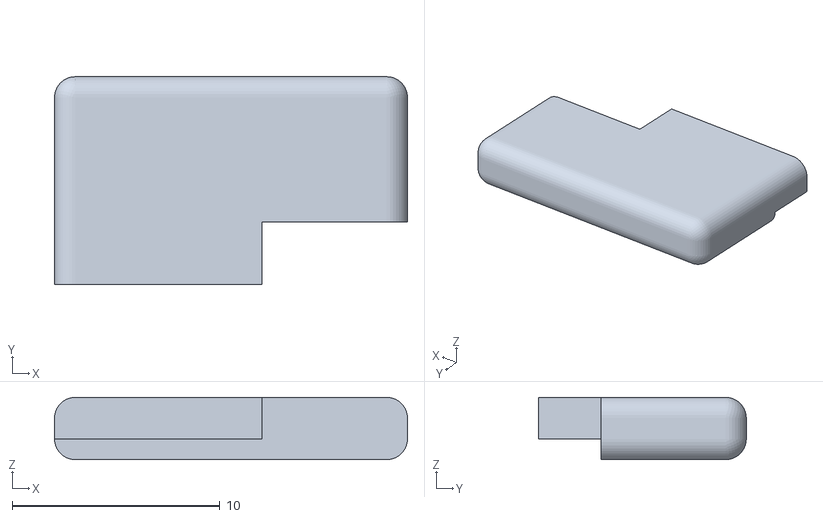
[picture p49: CAD file, 2025-07-17]
STLs/Xx_Endstop_Top .stl
17.0 x 10.0 x 3.00
