theworkisthework/terraPen-mechanical-design-files/STLs/X_Motor_Top.stl

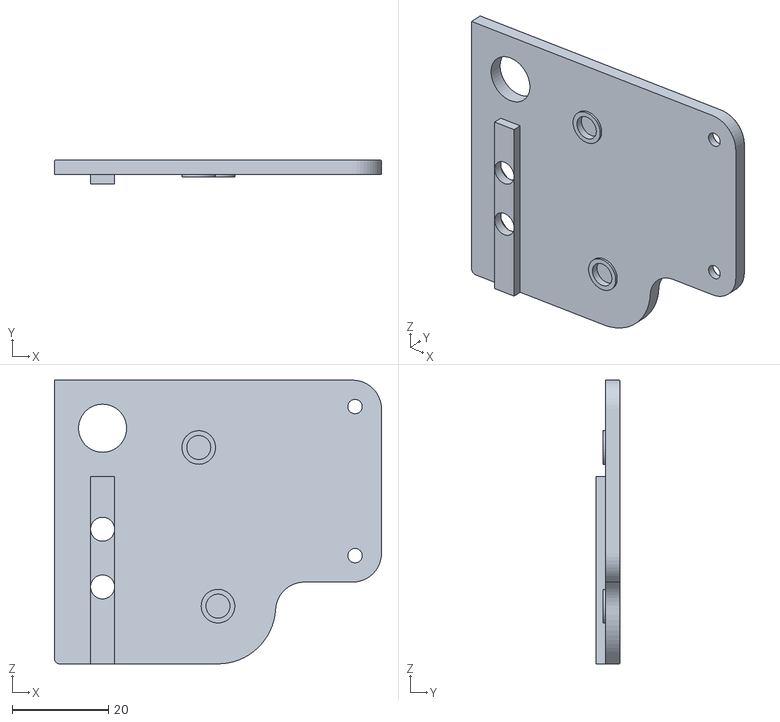
[picture p50: CAD file, 2025-07-17]
STLs/X_Motor_Top.stl
68.0 x 5.00 x 59.0
