theworkisthework/terraPen-mechanical-design-files/STLs/Belt_Clamp_Plate.stl

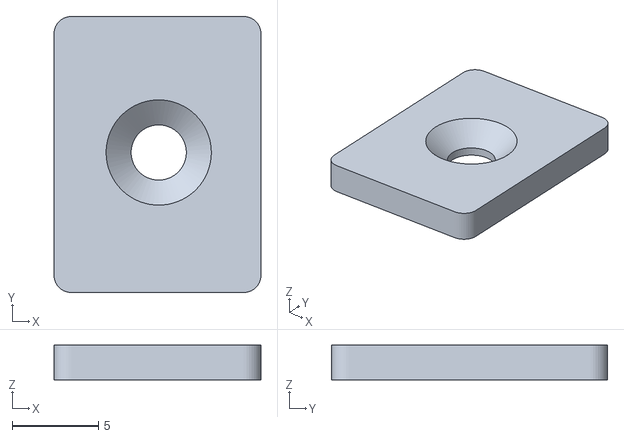
[picture p51: CAD file, 2025-07-17]
STLs/Belt_Clamp_Plate.stl
12.0 x 16.0 x 2.00
