theworkisthework/terraPen-mechanical-design-files/STLs/2xTensioner_bit.stl

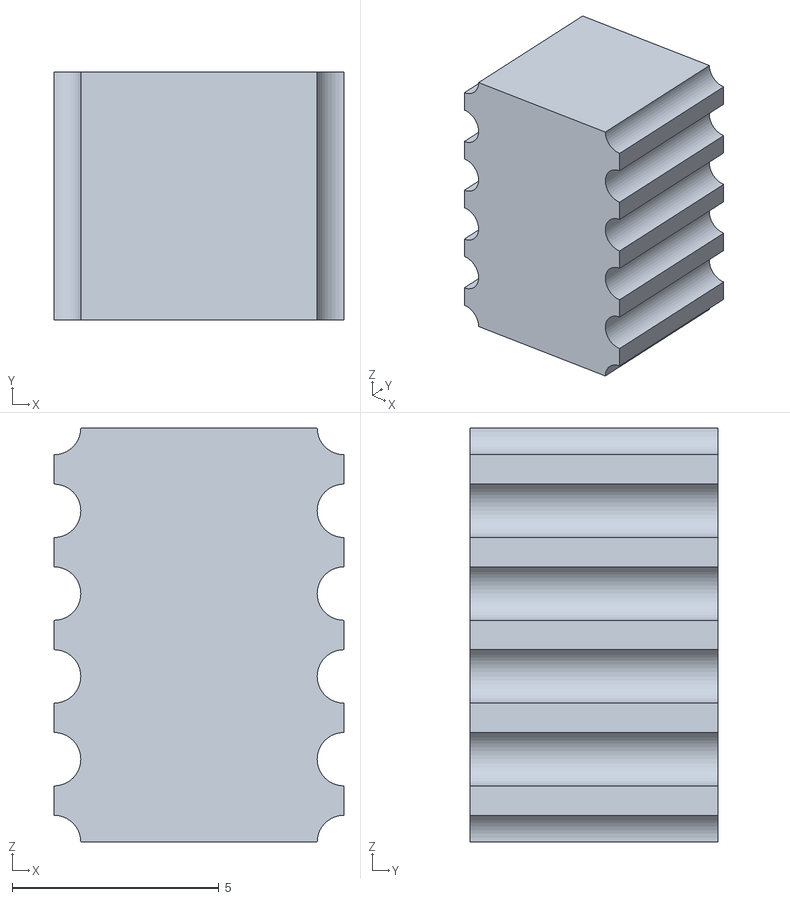
[picture p52: CAD file, 2025-07-17]
STLs/2xTensioner_bit.stl
7.00 x 6.00 x 10.0
