theworkisthework/terraPen-mechanical-design-files/STLs/Xx_Endstop_Bottom.stl

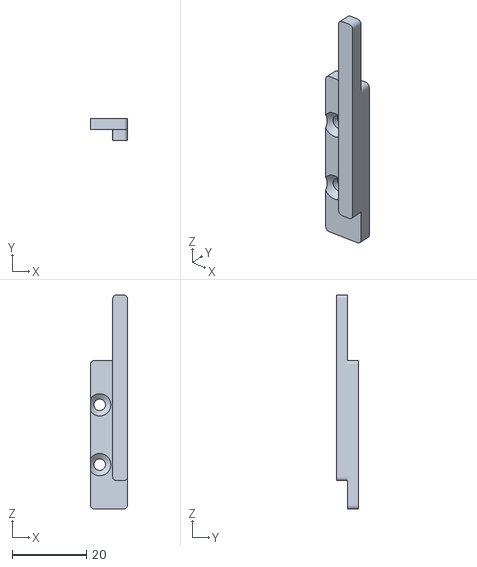
[picture p53: CAD file, 2025-07-17]
STLs/Xx_Endstop_Bottom.stl
10.00 x 6.00 x 57.6
