theworkisthework/terraPen-mechanical-design-files/STLs/Servo_Mounting_Plate.stl

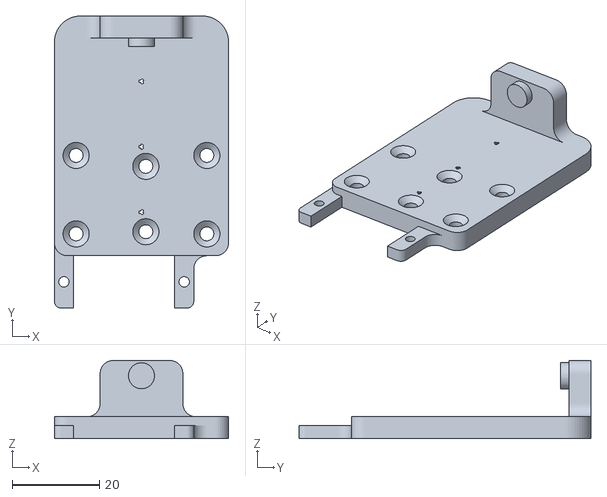
[picture p54: CAD file, 2025-07-17]
STLs/Servo_Mounting_Plate.stl
40.0 x 67.0 x 17.9
