theworkisthework/terraPen-mechanical-design-files/(list of files, cad)

Other CAD files:
STLs/TPU Bungs/6mm Aperture Bung.3mf
STLs/TPU Bungs/10mm Tapered Bung.stl
STLs/TPU Bungs/11mm Tapered Bung.stl
STLs/TPU Bungs/9mm Tapered Bung.stl
STLs/Servo_Pen_Holder_Front.stl
STLs/Servo_Pen_Clip_Latch.stl
STLs/8xTPU_Bumper.stl
STLs/TPU Bungs/12mm Aperture Bung.stl
STLs/TPU Bungs/15mm Aperture Bung.stl
STLs/TPU Bungs/4mm Aperture Bung.stl
STLs/TPU Bungs/6mm Aperture Bung.stl
STLs/TPU Bungs/9mm Aperture Bung.stl
