theworkisthework/terraPen-mechanical-design-files/(commit log)

2024-09-06 upload of STLs to TWITW
    [1x BCB.stl, 1x BCF.stl, 1x _XMB.stl, 1x_CBC.stl, 1x_CM.stl, 1x_ECB.stl, 1x_ECBC.stl, 1x_EE.stl]
2024-09-06 upload of step assembly file
2024-09-17 Prototype angled pen mounting
    [Angled pen mounting bracket.stl, Pen mount.stl, Universal tool head mounting plate.stl]
2024-09-19 updated XYT
    [1x_XYT.stl]
2024-09-25 updated XRM, XMB, XMT, YMT, YMB
    [1x _XMB.stl, 1x_XMT.stl, 1x_XRM.stl, 1x_YMB.stl, 1x_YMT.stl]
2024-12-01 Update terraPenA2 BOM.xlsx
    [terraPenA2 BOM.xlsx]
2025-02-08 prototype servo pen lift with centered pen
    [10mm Tapered Bung.stl, 11mm Tapered Bung.stl, 16_3mm Tapered Bung.stl, 8mm Tapered Bung.stl, 9mm Tapered Bung.stl, FrontMountingPlate.stl, Latch.stl, Link.stl]
2025-02-08 updated file path
    [10mm Tapered Bung.stl, 11mm Tapered Bung.stl, 16_3mm Tapered Bung.stl, 8mm Tapered Bung.stl, 9mm Tapered Bung.stl, FrontMountingPlate.stl, Latch.stl, Link.stl]
2025-02-08 Create Prototype servo mount with centered pen.step
    [Prototype servo mount with centered pen.step]
2025-02-25 updated STLs
    including pen holders
    [10mm Tapered Bung.stl, 11mm Tapered Bung.stl, 16_3mm Tapered Bung.stl, 1x BCB.stl, 1x BCF.stl, 1x _XMB.stl, 1x_CBC.stl, 1x_CM.stl]
2025-03-04 solenoid with centered pen clip + pen height guage
    [Prototype servo mount with centered pen.step, bung holder.stl, pen height setter slider.stl]
2025-05-22 Add bungs with aperture/fingers
    [12mm Aperture Bung.3mf, 15mm Aperture Bung.3mf, 6mm Aperture Bung.3mf, 9mm Aperture Bung.3mf, aperture bung.FCStd]
2025-05-22 Add STLs because github doesn't render 3mf files as 3d models
    [12mm Aperture Bung.stl, 15mm Aperture Bung.stl, 6mm Aperture Bung.stl, 9mm Aperture Bung.stl]
2025-05-22 Fix empty STL exports
    [12mm Aperture Bung.stl, 9mm Aperture Bung.stl]
2025-05-22 Add a 4mm aperture bung because the 6mm is too big for a pencil
    [4mm Aperture Bung.3mf, 4mm Aperture Bung.stl]
2025-05-27 Alternate plotter head (#1)
    * initial CAD files
    * added README
    [Pen Holder Insert.FCStd]
2025-05-28 updated alternate plotter head
    * fix inner sleeve thickness
    * tweaks to resolve tolerance issues
    * updated readme for alternate plotter head
    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
    [Pen Holder Insert.FCStd]
2025-05-28 fix alt plotter head readme (#3)
    * updated alt plotter readme
    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
2025-06-04 updated alternate plotter head (#4)
    * updated design after testing
    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
2025-07-17 reupload of terraPen Source and STL
    [10mm Tapered Bung.stl, 11mm Tapered Bung.stl, 16_3mm Tapered Bung.stl, 2xTensioner_bit.stl, 2xTensoiner Bit.stl, 8mm Tapered Bung.stl, 9mm Tapered Bung.stl, Angled pen mounting bracket.stl]
2025-07-17 rename folder
    [Pen Holder Insert.FCStd]
2026-10-12 updated BOM
    BOM is WIP
2026-10-16 removed stepper z folder
    old
2026-10-23 added cable chain support
2026-10-24 updated bom
2026-10-24 added internal BOM with gitnore
